paulkilroy/EllaFi/kicad/EllaFi-PCB.kicad_pcb

## KiCad design kicad/EllaFi-PCB.kicad_pcb (2026-08-12)

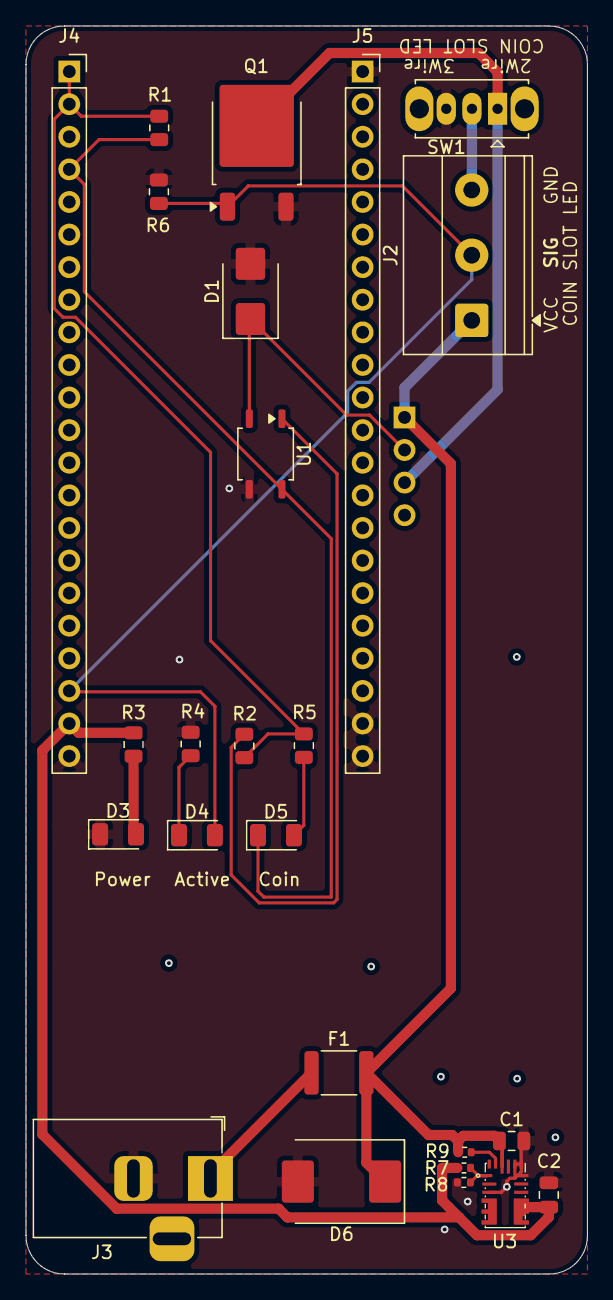
[picture p2: board EllaFi-PCB.kicad_pcb from above]

Board: 2 copper layers, 43.8 x 97.2 mm, 26 parts (1 on the bottom side), 16 nets.

Parts:
C1: 10 µF; C_0805_2012Metric
C2: 22 µF; C_0805_2012Metric
D1: P6SMB6.8A; D_SMB
D3: LED-RED; LED_1206_3216Metric
D4: LED-YELLOW; LED_1206_3216Metric
D5: LED-GREEN; LED_1206_3216Metric
D6: 1.5SMC18A; D_SMC
F1: MINISMDC150F/16-2; Fuse_1812_4532Metric
J1: Conn_01x04_Socket; PinSocket_1x04_P2.54mm_Vertical
J2: Conn_01x03; TerminalBlock_Phoenix_MKDS-1,5-3-5.08_1x03_P5.08mm_Horizont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
J3: PJ-002AH; BarrelJack_Horizontal
J4, J5: Conn_01x22_Socket; PinSocket_1x22_P2.54mm_Vertical
Q1: AOD4184A; TO-252-2
R1: 2.2k; R_0805_2012Metric
R2, R4: 220; R_0805_2012Metric
R3: 330; R_0805_2012Metric
R5: 1k; R_0805_2012Metric
R6: 10k; R_0805_2012Metric
R7, R9: 100 kΩ; R_0402_1005Metric
R8: 19.1 kΩ; R_0402_1005Metric
SW1: OS102011MS2QN1; SW_Slide_SPDT_Straight_CK_OS102011MS2Q
U1: FOD817S; SOP-4_3.8x4.1mm_P2.54mm
U3: MPM3620AGQV-Z; QFN-20_L5.0-W3.0-TL-MPM3630GQV-Z

Connections:
+12V: F1.1, J3.1
/3V3: J4.1, J4.2, R1.2, R2.1, R5.1
/5V: C2.1, J4.21, R3.1, R7.1, U3.9 (OUT)
/GPIO4: D5.1 (K), J4.4, R1.1, U1.4
/GPIO14: D4.2 (A), J2.2, J4.20, Q1.1 (G), R6.2
GND: C1.2, C2.2, D1.2 (A2), D3.1 (K), D6.2 (A2), J3.2, J4.22, J5.1, J5.21, J5.22, Q1.3 (S), R4.2, R6.1, R8.2, SW1.3 (C), U1.3, U3.3 (AGND), U3.12 (PGND), U3.13 (PGND), U3.14 (PGND)
unnamed: D1.1 (A1), J1.2, U1.2
unnamed: D3.2 (A), R3.2
unnamed: D4.1 (K), R4.1
unnamed: D5.2 (A), R5.2
unnamed: C1.1, D6.1 (A1), F1.2, J1.1, J2.1, R9.1, U3.16 (IN)
unnamed: J1.3, Q1.2 (D), SW1.1 (A)
unnamed: J2.3, SW1.2 (B)
unnamed: R2.2, U1.1
unnamed: R9.2, U3.17 (EN)
unnamed: R7.2, R8.1, U3.1 (FB)
