paulkilroy/EllaFi/src/web.cpp

#include "web.h"
#include "network.h"
#include "log_buffer.h"
#include "money_store.h"

#include <LittleFS.h>
#include <ESPmDNS.h>
#include <ArduinoJson.h>
#include <map>
#include <set>
#include <vector>
#include <Update.h>
#include <Preferences.h>
#include <HTTPClient.h>
#include <WiFiClientSecure.h>
#include "lwip/sockets.h"   // setsockopt + SO_KEEPALIVE / TCP_KEEPIDLE for per-socket TCP keepalive
#include <esp_ota_ops.h>
#include <esp_partition.h>
#include <PsychicUploadHandler.h>
#include <mbedtls/base64.h>
#include <mbedtls/md.h>
#include <esp_random.h>
#include <esp_log.h>
#include "logger.h"

static const char* TAG = "EllaFi";

// ── Admin auth: challenge-response login + IP-bound session token ──────────────
// HTTP Basic mailed the Omada password (base64) on every request. Instead, the browser sends
// sha256(nonce:password) — the password never crosses the wire — and on success the cookie is a
// token DERIVED from the password (sha256 of a salt + password), not a random session: no server
// state, so it survives the daily reboot and brownouts, and every admin device shares it. Changing
// the password is the revocation. The server is single-threaded (one httpd task), so these tables
// need no lock.

static const uint32_t ADMIN_NONCE_TTL_MS     = 60000UL;        // 1 min to finish a login
static const int      ADMIN_MAX_FAILS        = 5;              // failed logins per IP before cooldown
static const uint32_t ADMIN_FAIL_COOLDOWN_MS = 60000UL;        // lockout window once tripped

struct AdminNonce   { String nonce; uint32_t expiresMs; };
struct AdminFails   { uint32_t ip; int count; uint32_t untilMs; };

static AdminNonce   ADMIN_NONCES[8];
static AdminFails   ADMIN_FAILS[8];

static bool ttlLive(uint32_t expiresMs, uint32_t now) { return (int32_t)(expiresMs - now) > 0; }

static uint32_t reqIpU32(PsychicRequest* request) {
  IPAddress ip = request->client()->remoteIP();
  return ((uint32_t)ip[0] << 24) | ((uint32_t)ip[1] << 16) | ((uint32_t)ip[2] << 8) | (uint32_t)ip[3];
}

static String randomHex(int nbytes) {
  String s; s.reserve(nbytes * 2);
  for (int i = 0; i < nbytes; i++) { char b[3]; snprintf(b, sizeof(b), "%02x", (unsigned)(esp_random() & 0xff)); s += b; }
  return s;
}

static String sha256Hex(const String& in) {
  uint8_t out[32];
  mbedtls_md(mbedtls_md_info_from_type(MBEDTLS_MD_SHA256), (const uint8_t*)in.c_str(), in.length(), out);
  String hex; hex.reserve(64);
  for (int i = 0; i < 32; i++) { char b[3]; snprintf(b, sizeof(b), "%02x", out[i]); hex += b; }
  return hex;
}

// Constant-time compare of two equal-length strings.
static bool ctEqual(const String& a, const String& b) {
  if (a.length() != b.length()) return false;
  uint8_t diff = 0;
  for (size_t i = 0; i < a.length(); i++) diff |= (uint8_t)(a[i] ^ b[i]);
  return diff == 0;
}

static String cookieValue(PsychicRequest* request, const char* name) {
  size_t len = httpd_req_get_hdr_value_len(request->request(), "Cookie");
  if (len == 0 || len >= 512) return "";
  char buf[512] = {};
  httpd_req_get_hdr_value_str(request->request(), "Cookie", buf, sizeof(buf));
  String cookies(buf);
  String key = String(name) + "=";
  int p = cookies.indexOf(key);
  if (p < 0) return "";
  p += key.length();
  int e = cookies.indexOf(';', p);
  String v = (e < 0) ? cookies.substring(p) : cookies.substring(p, e);
  v.trim();
  return v;
}

// The persistent admin cookie value: derived from the password, computed once. Not IP-bound (phones
// hop DHCP leases) and never expires — accepted tradeoff on this LAN; rotate the password to revoke.
static String persistentToken() {
  static String token;
  if (token.isEmpty()) token = sha256Hex("ellafi-cookie-v1:" + ADMIN_PASSWORD);
  return token;
}

static bool isAuthorized(PsychicRequest* request) {
  return ctEqual(cookieValue(request, "ellafi_admin"), persistentToken());
}

// Admin gate as a pipeline middleware — attach with ->addMiddleware(adminAuth) on protected routes.
// Runs before the handler; 401s unauthenticated requests so the policy lives in the route table (not
// scattered through handler bodies).
static PsychicMiddlewareCallback adminAuth =
  [](PsychicRequest* request, PsychicResponse* response, PsychicMiddlewareNext next) -> esp_err_t {
    if (!isAuthorized(request))
      return response->send(401, "application/json", "{\"error\":\"auth required\"}");  // client renders its own login
    return next();
  };

static esp_err_t handleAdminChallenge(PsychicRequest* request, PsychicResponse* response) {
  uint32_t now = millis();
  String nonce = randomHex(16);
  int slot = 0; uint32_t oldest = 0xffffffffUL;
  for (int i = 0; i < 8; i++) {
    if (!ttlLive(ADMIN_NONCES[i].expiresMs, now)) { slot = i; break; }   // free/expired
    if (ADMIN_NONCES[i].expiresMs < oldest) { oldest = ADMIN_NONCES[i].expiresMs; slot = i; }
  }
  ADMIN_NONCES[slot] = { nonce, now + ADMIN_NONCE_TTL_MS };
  response->addHeader("Cache-Control", "no-store");
  return response->send(200, "application/json", (String("{\"nonce\":\"") + nonce + "\"}").c_str());
}

static void recordFail(uint32_t ip, uint32_t now) {
  for (auto& f : ADMIN_FAILS) if (f.ip == ip) {
    if (!ttlLive(f.untilMs, now)) f.count = 0;   // window elapsed → start over
    f.count++; f.untilMs = now + ADMIN_FAIL_COOLDOWN_MS; return;
  }
  for (auto& f : ADMIN_FAILS) if (f.ip == 0 || !ttlLive(f.untilMs, now)) {
    f = { ip, 1, now + ADMIN_FAIL_COOLDOWN_MS }; return;
  }
}
static void clearFails(uint32_t ip) { for (auto& f : ADMIN_FAILS) if (f.ip == ip) f = {}; }
static bool throttled(uint32_t ip, uint32_t now) {
  for (auto& f : ADMIN_FAILS) if (f.ip == ip && f.count >= ADMIN_MAX_FAILS && ttlLive(f.untilMs, now)) return true;
  return false;
}

static esp_err_t handleAdminLogin(PsychicRequest* request, PsychicResponse* response) {
  uint32_t now = millis(), ip = reqIpU32(request);
  if (throttled(ip, now)) return response->send(429, "application/json", "{\"error\":\"too many attempts — wait a minute\"}");

  JsonDocument doc;
  if (deserializeJson(doc, request->body())) return response->send(400, "application/json", "{\"error\":\"bad request\"}");
  String nonce  = doc["nonce"].as<String>();
  String digest = doc["digest"].as<String>();

  bool nonceOk = false;
  for (auto& n : ADMIN_NONCES) if (!n.nonce.isEmpty() && n.nonce == nonce && ttlLive(n.expiresMs, now)) {
    n = {};            // burn — use once
    nonceOk = true; break;
  }

  bool ok = nonceOk && digest.length() == 64 && ctEqual(digest, sha256Hex(nonce + ":" + ADMIN_PASSWORD));
  if (!ok) {
    recordFail(ip, now);
    return response->send(401, "application/json", "{\"error\":\"invalid password\"}");
  }
  clearFails(ip);

  // Persistent cookie (10 years) — survives the daily reboot and brownouts; no re-login.
  String cookie = "ellafi_admin=" + persistentToken() + "; Path=/; Max-Age=315360000; HttpOnly; SameSite=Strict";
  response->addHeader("Set-Cookie", cookie.c_str());
  return response->send(200, "application/json", "{\"ok\":true}");
}

static esp_err_t handleAdminLogout(PsychicRequest* request, PsychicResponse* response) {
  response->addHeader("Set-Cookie", "ellafi_admin=; Path=/; Max-Age=0; HttpOnly; SameSite=Strict");
  return response->send(200, "application/json", "{\"ok\":true}");
}

static esp_err_t handleSha256Js(PsychicRequest* request, PsychicResponse* response) {
  response->addHeader("Cache-Control", "max-age=86400");
  return response->send(200, "application/javascript",
    (const uint8_t*)web_sha256_min_js_start,
    web_sha256_min_js_end - web_sha256_min_js_start);
}

esp_err_t handleAdminPage(PsychicRequest* request, PsychicResponse* response) {
  // Unauthenticated on purpose: the page renders its own login overlay, then the gated
  // data endpoints (/admin/nodes, etc.) enforce auth.
  response->addHeader("Cache-Control", "no-store");
  return response->send(200, "text/html",
    (const uint8_t*)web_admin_html_start,
    web_admin_html_end - web_admin_html_start);
}

// ── HTTP / WS handlers ────────────────────────────────────────────────────────

// Seed the session cache from Omada's redirect params (clientMac required, rest best-effort) and
// restore any paused time from disk. Shared by handleRoot (ESP-served portal: params on GET /) and
// handleGetStatus (controller-hosted portal: params on GET /status — the page loads from the OC220,
// so this is the only request that can carry them).
static SessionParams& seedPortalSession(PsychicRequest* request, const String& clientIp, const String& clientMac) {
  SessionParams& session = HOTSPOT_SESSION_CACHE.upsert(clientIp, clientMac);
  if (request->hasParam("apMac"))    session.apMac    = request->getParam("apMac")->value();
  if (request->hasParam("ssidName")) session.ssidName = request->getParam("ssidName")->value();
  if (request->hasParam("radioId"))  session.radioId  = request->getParam("radioId")->value();

  // Load paused session from disk if needed (outside session mutex — only LittleFS I/O)
  if (hasPausedSessionFile(clientMac) && session.pausedRemainingMillis == 0)
    session.pausedRemainingMillis = loadPausedSessionFile(clientMac);
  return session;
}

// Serve captive portal page. Omada redirects here with query params:
// ?clientMac=...&apMac=...&ssidName=...&radioId=...&site=...&redirectUrl=...
esp_err_t handleRoot(PsychicRequest* request, PsychicResponse* response) {
#ifdef TEST_MODE
  String clientIp = request->hasParam("clientIp") ? request->getParam("clientIp")->value() : request->client()->remoteIP().toString();
#else
  String clientIp = request->client()->remoteIP().toString();
#endif
  String clientMac  = request->hasParam("clientMac")  ? request->getParam("clientMac")->value()  : "";
  String apMac      = request->hasParam("apMac")      ? request->getParam("apMac")->value()      : "";
  String ssidName   = request->hasParam("ssidName")   ? request->getParam("ssidName")->value()   : "";
  String radioId    = request->hasParam("radioId")    ? request->getParam("radioId")->value()     : "";

  SessionParams* existing = HOTSPOT_SESSION_CACHE.findByIp(clientIp);
  bool isNew = (existing == nullptr || existing->clientMac.isEmpty());

  ESP_LOGD(TAG, "handleRoot [%s] ip=%s mac=%s apMac=%s ssid=%s radioId=%s paused=%lums openConn=%d",
    isNew ? "NEW" : "RETURNING",
    clientIp.c_str(), clientMac.c_str(), apMac.c_str(),
    ssidName.c_str(), radioId.c_str(),
    existing ? existing->pausedRemainingMillis : 0UL,
    (int)HTTP_SERVER.getClientList().size());

  // Guard: if clientMac is missing, look up by IP — do NOT upsert yet (would create a phantom entry)
  if (clientMac.isEmpty()) {
    if (!existing || existing->clientMac.isEmpty()) {
      ESP_LOGI(TAG, "No MAC for IP %s — rejecting portal request", clientIp.c_str());
      return response->send(200, "text/html",
        (const uint8_t*)web_unidentified_html_start,
        web_unidentified_html_end - web_unidentified_html_start);
    }
    clientMac = existing->clientMac;
    ESP_LOGI(TAG, "Restored MAC %s from cache for IP %s", clientMac.c_str(), clientIp.c_str());
  }

  seedPortalSession(request, clientIp, clientMac);

  response->addHeader("Connection", "close");
  response->addHeader("Cache-Control", "no-store");
  return response->send(200, "text/html",
    (const uint8_t*)web_index_html_start,
    web_index_html_end - web_index_html_start);
}

esp_err_t handleGetStatus(PsychicRequest* request, PsychicResponse* response) {
#ifdef TEST_MODE
  String clientIp = request->hasParam("clientIp") ? request->getParam("clientIp")->value() : request->client()->remoteIP().toString();
#else
  String clientIp = request->client()->remoteIP().toString();
#endif
  // Controller-hosted portal: the page can't seed the session via GET / (it loads from the OC220),
  // so it passes Omada's redirect params here instead — same fields, same trust as handleRoot.
  SessionParams* session = request->hasParam("clientMac")
    ? &seedPortalSession(request, clientIp, request->getParam("clientMac")->value())
    : HOTSPOT_SESSION_CACHE.findByIp(clientIp);
  // AP status is global, not per-session — include it even when this client has no session, or the
  // coverage-map dots stay grey for anyone who hasn't paid yet (i.e. most captive-page viewers).
  String json = session ? buildStatusJson(*session)
    : "{\"type\":\"status\",\"sessionEndMillis\":0,\"pausedRemainingMillis\":0,\"coinInsertTimeLeft\":0,\"devices\":"
      + deviceStatusJson() + "}";
  response->addHeader("Cache-Control", "no-store");
  response->addHeader("Access-Control-Allow-Origin", "*");   // readable from the controller-hosted page
  return response->send(200, "application/json", json.c_str());
}

esp_err_t handleNotFound(PsychicRequest* request, PsychicResponse* response) {
  String host = request->host();
  String url  = request->url();  // full path + query string
  if (host != "ellafi.local" && host != WiFi.localIP().toString())
    ESP_LOGI(TAG, "404 unexpected host: %s %s", host.c_str(), url.c_str());  // captive-portal probes — expected, not an error
  else
    ESP_LOGI(TAG, "404: %s", url.c_str());
  return response->send(404, "text/plain", "Not found");
}

esp_err_t handleProgram(PsychicRequest* request, PsychicResponse* response) {
  COINSLOT_PROGRAM_MODE = true;
  digitalWrite(COINSLOT_POWER_PIN, HIGH);
  ESP_LOGI(TAG, "Coin slot program mode enabled — relay held HIGH until restart");
  return response->send(200, "text/plain", "Coin slot program mode ON — power held until restart.\nRestart ESP32 to exit.");
}

static String formatTimestamp(long ts) {
  char buf[20];
  time_t t = (time_t)ts;
  struct tm* tm = gmtime(&t);
  strftime(buf, sizeof(buf), "%Y-%m-%d %H:%M:%S", tm);
  return String(buf);
}

esp_err_t handleRefunds(PsychicRequest* request, PsychicResponse* response) {
  if (!fsExists("/refunds.log")) return response->send(200, "text/plain", "No refunds logged.");
  File f = LittleFS.open("/refunds.log", FILE_READ);
  if (!f) return response->send(500, "text/plain", "Could not open refunds.log");
  String out = "REFUNDS\n=======\n";
  while (f.available()) {
    String line = f.readStringUntil('\n');
    line.trim();
    if (line.isEmpty()) continue;
    JsonDocument doc;
    if (deserializeJson(doc, line) != DeserializationError::Ok) continue;
    out += formatTimestamp(doc["ts"] | 0L);
    out += "  " + String(doc["mac"] | "?");
    out += "  " + String(doc["coins"] | 0) + " coin(s)";
    out += " / " + String(doc["minutes"] | 0) + " min";
    out += "  Code: " + String(doc["code"] | "?");
    out += "\n";
  }
  f.close();
  return response->send(200, "text/plain", out.c_str());
}

esp_err_t handleErrors(PsychicRequest* request, PsychicResponse* response) {
  if (!fsExists("/errors.log")) return response->send(200, "text/plain", "No errors logged.");

  // Render only the most recent entries. The file can hold hundreds; assembling them all into one
  // String overruns the heap (yields an empty/failed response). Two passes: count, then skip all
  // but the last MAX_SHOW so `out` stays small regardless of file size.
  const int MAX_SHOW = 200;
  int total = 0;
  {
    File f = LittleFS.open("/errors.log", FILE_READ);
    if (!f) return response->send(500, "text/plain", "Could not open errors.log");
    while (f.available()) { String l = f.readStringUntil('\n'); l.trim(); if (!l.isEmpty()) total++; }
    f.close();
  }
  int skip = total > MAX_SHOW ? total - MAX_SHOW : 0;

  File f = LittleFS.open("/errors.log", FILE_READ);
  if (!f) return response->send(500, "text/plain", "Could not open errors.log");
  String out = "ERRORS\n======\n";
  if (skip) out += "(showing last " + String(MAX_SHOW) + " of " + String(total) + ")\n";
  int idx = 0;
  while (f.available()) {
    String line = f.readStringUntil('\n');
    line.trim();
    if (line.isEmpty()) continue;
    if (idx++ < skip) continue;
    JsonDocument doc;
    if (deserializeJson(doc, line) != DeserializationError::Ok) continue;
    long ts = doc["ts"] | 0L;
    if (ts < NTP_EPOCH_MIN)   // logged before clock sync (power-cut boot) — only boot-relative time exists
      out += "(boot +" + String((doc["ms"] | 0UL) / 1000) + "s)      ";
    else
      out += formatTimestamp(ts);
    out += "  [" + String(doc["tag"] | "?") + "]";
    out += "  " + String(doc["msg"] | "?");
    out += "\n";
  }
  f.close();
  return response->send(200, "text/plain", out.c_str());
}

void handleWsOpen(PsychicWebSocketClient* client) {
  int socketFd = client->socket();
  String clientIp = client->remoteIP().toString();
  ESP_LOGI(TAG, "WS client connected: socket #%d from %s", socketFd, clientIp.c_str());

  SessionParams* session = HOTSPOT_SESSION_CACHE.findByIp(clientIp);
  if (session) {
    session->socketFd = socketFd;
    ESP_LOGI(TAG, "WS client has session: socket #%d -> MAC %s", socketFd, session->clientMac.c_str());
  } else {
    ESP_LOGI(TAG, "WS socket #%d from %s: no cached session for this IP", socketFd, clientIp.c_str());
  }

  if (coinSessionUpdateSocket(clientIp, socketFd))
    ESP_LOGI(TAG, "Updated coin-session socket to %d (client reconnected)", socketFd);
}

// Reply with a terminal error, then aggressively close the socket. These are dead-end replies —
// the client can't act further on this connection — and a backgrounded/stale client may never close
// on its own, pinning a slot in PsychicHttp's small socket pool. close() just triggers an async
// close (httpd_sess_trigger_close), so it's safe from inside the frame handler.
static esp_err_t wsError(PsychicWebSocketRequest* request, const char* json) {
  request->reply(json);
  request->client()->close();
  return ESP_OK;
}

esp_err_t handleWsRequest(PsychicWebSocketRequest* request, httpd_ws_frame* frame) {
  int socketFd = request->client()->socket();
  String clientIp = request->client()->remoteIP().toString();
  String payload((char*)frame->payload, frame->len);

  JsonDocument doc;
  DeserializationError error = deserializeJson(doc, payload);
  if (error) {
    ESP_LOGE(TAG, "WS JSON parse error (%s): %.200s", error.c_str(), payload.c_str());
    return wsError(request, "{\"type\":\"error\",\"message\":\"Invalid WS JSON Request\"}");
  }

#ifdef TEST_MODE
  String payloadIp = doc["clientIp"] | "";
  if (!payloadIp.isEmpty()) clientIp = payloadIp;
#endif

  ESP_LOGD(TAG, "WS frame from socket #%d: clientIp=%s action=%s", socketFd, clientIp.c_str(), (doc["action"] | ""));

  SessionParams* session = HOTSPOT_SESSION_CACHE.findByIp(clientIp);
  if (session) {
    session->socketFd = socketFd;
    session->clientIp = clientIp;
  }

  if (!session) {
    return wsError(request, "{\"type\":\"error\",\"subtype\":\"no_session\",\"message\":\"No portal session found for this device\"}");
  }

  String action = doc["action"] | "";

  if (action == "getStatus") {
    if (coinSessionUpdateSocket(clientIp, socketFd))
      ESP_LOGI(TAG, "Updated coin-session socket to %d (client reconnected)", socketFd);
    request->client()->sendMessage(buildStatusJson(*session).c_str());

  } else if (action == "startCoinInsert") {
    if (!isServiceReady()) {
      return wsError(request, "{\"type\":\"error\",\"message\":\"Temporarily out of service — please try again shortly\"}");
    } else if (coinSessionTryClaim(socketFd, clientIp)) {
      ESP_LOGI(TAG, "Coin insertion started for MAC: %s via WS", session->clientMac.c_str());
      request->client()->sendMessage(buildStatusJson(*session).c_str());
    } else {
      return wsError(request, "{\"type\":\"error\",\"message\":\"Another user already inserting coins\"}");
    }

  } else if (action == "pause") {
    WsJob job(JOB_PAUSE, session->clientMac);
    xQueueSend(WEBSOCKET_JOB_QUEUE, &job, 0);

  } else if (action == "resume") {
    WsJob job(JOB_RESUME, session->clientMac);
    xQueueSend(WEBSOCKET_JOB_QUEUE, &job, 0);

#ifdef TEST_MODE
  } else if (action == "testInsertCoin") {
    // Simulate a coin pulse (assumes startCoinInsert was called first)
    coinButtonPulse();
    ESP_LOGI(TAG, "Test coin inserted for MAC: %s (count: %d)", session->clientMac.c_str(), COIN_COUNT.load());
#endif
  } else {
    return wsError(request, "{\"type\":\"error\",\"message\":\"Unknown action\"}");
  }

  return ESP_OK;
}

void handleWsClose(PsychicWebSocketClient* client) {
  ESP_LOGI(TAG, "WS client disconnected: socket #%d", client->socket());
}

String buildStatusJson(const SessionParams& session, const char* type) {
  CoinSessionStatus cs = coinSessionSnapshot();
  bool myCoinInsertActive = cs.accepting && coinIpToU32(session.clientIp) == cs.clientIpV4;
  int coinInsertTimeLeft = 0;
  if (myCoinInsertActive) {
    unsigned long now = millis();
    if (cs.deadlineMs > now) coinInsertTimeLeft = (cs.deadlineMs - now) / 1000;
  }

  String json = "{";
  json += "\"type\":\"" + String(type) + "\",";
  json += "\"coinCount\":" + String(myCoinInsertActive ? cs.count : 0) + ",";
  json += "\"coinInsertTimeLeft\":" + String(coinInsertTimeLeft) + ",";
  json += "\"sessionStartMillis\":" + String((unsigned long long)session.sessionStartMillis) + ",";
  json += "\"sessionEndMillis\":" + String((unsigned long long)session.sessionEndMillis) + ",";
  json += "\"pausedRemainingMillis\":" + String(session.pausedRemainingMillis) + ",";
  json += "\"clientMac\":\"" + session.clientMac + "\",";
  json += "\"clientIp\":\"" + session.clientIp + "\",";
  json += "\"minutesPerCoin\":" + String(MINUTES_PER_COIN);
  json += ",\"devices\":" + deviceStatusJson();   // AP coverage map: {mac:status} (2=online 1=issue 0=offline)
  json += "}";

  return json;
}

void pushCoinUpdateToClient() {
  CoinSessionStatus cs = coinSessionSnapshot();
  if (cs.socketFd < 0 || cs.clientIpV4 == 0) return;

  SessionParams* session = HOTSPOT_SESSION_CACHE.findByIp(coinU32ToIp(cs.clientIpV4));
  if (!session) return;

  PsychicWebSocketClient* ws = WEBSOCKET_HANDLER.getClient(cs.socketFd);
  if (ws != nullptr) ws->sendMessage(buildStatusJson(*session).c_str());
}

// ── OTA update ───────────────────────────────────────────────────────────────

void setupOtaRoute() {
  PsychicUploadHandler* otaHandler = new PsychicUploadHandler();

  otaHandler->onUpload([](PsychicRequest* request, const String& /*filename*/,
                          uint64_t index, uint8_t* data, size_t len, bool final) -> esp_err_t {
    if (index == 0) {
      if (!isAuthorized(request)) {
        ESP_LOGW(TAG, "OTA upload rejected: unauthorized");
        return ESP_FAIL;
      }
      size_t contentLen = request->contentLength();
      ESP_LOGI(TAG, "OTA fw upload start: %zu bytes", contentLen);
      if (!Update.begin(contentLen)) {
        ESP_LOGE(TAG, "OTA Update.begin failed: %s", Update.errorString());
        return ESP_FAIL;
      }
      ESP_LOGI("ota", "fw Update.begin OK");
    }

    if (Update.write(data, len) != len) {
      ESP_LOGE(TAG, "OTA write failed at offset %llu len %zu", index, len);
      return ESP_FAIL;
    }

    if (final) {
      ESP_LOGI("ota", "fw final chunk received: %llu bytes total — calling Update.end", index + len);
      if (!Update.end(true)) {
        ESP_LOGE(TAG, "OTA Update.end failed: %s", Update.errorString());
        return ESP_FAIL;
      }
      ESP_LOGI("ota", "fw Update.end OK — partition committed");
    }
    return ESP_OK;
  });

  otaHandler->onRequest([](PsychicRequest* /*request*/, PsychicResponse* response) -> esp_err_t {
    ESP_LOGI("ota", "fw onRequest fired — sending 200 OK, reboot in 500ms");
    response->send(200, "application/json", "{\"ok\":true}");
    // Reboot master — slaves detect version mismatch via heartbeat and self-update
    TimerHandle_t t = xTimerCreate("OtaReboot", pdMS_TO_TICKS(500), pdFALSE, NULL,
                                   [](TimerHandle_t) { esp_restart(); });
    if (t) xTimerStart(t, 0);
    else   esp_restart();
    return ESP_OK;
  });

  HTTP_SERVER.maxUploadSize = 16 * 1024 * 1024;
  HTTP_SERVER.on("/update", HTTP_POST, otaHandler);
}

// ── Firmware serve (for slave OTA) ───────────────────────────────────────────

esp_err_t handleFwBin(PsychicRequest* request, PsychicResponse* response) {
  uint32_t fw_size = RUNNING_IMAGE_SIZE;  // true running-image size — never a stale stored value

  if (fw_size == 0) {
    ESP_LOGW(TAG, "/fw.bin requested by %s but running image size is 0", request->client()->remoteIP().toString().c_str());
    return response->send(404, "text/plain", "Not found");
  }

  ESP_LOGI(TAG, "/fw.bin requested by %s — serving %u bytes from running partition",
           request->client()->remoteIP().toString().c_str(), (unsigned)fw_size);

  const esp_partition_t* partition = esp_ota_get_running_partition();
  response->addHeader("Content-Disposition", "attachment; filename=\"firmware.bin\"");

  // Stream directly from flash via mmap — no PSRAM copy needed.
  // response->send() with a raw pointer is synchronous, so munmap after is safe.
  const void* mapped = nullptr;
  spi_flash_mmap_handle_t mmap_handle;
  if (esp_partition_mmap(partition, 0, fw_size, SPI_FLASH_MMAP_DATA,
                         &mapped, &mmap_handle) == ESP_OK) {
    esp_err_t err = response->send(200, "application/octet-stream",
                                   (const uint8_t*)mapped, fw_size);
    spi_flash_munmap(mmap_handle);
    ESP_LOGI(TAG, "/fw.bin sent to %s (err=%d)", request->client()->remoteIP().toString().c_str(), err);
    return err;
  }

  // mmap failed — fall back to PSRAM copy
  ESP_LOGW(TAG, "/fw.bin: mmap failed, falling back to PSRAM copy");
  uint8_t* buf = (uint8_t*)heap_caps_malloc(fw_size, MALLOC_CAP_SPIRAM);
  if (!buf) {
    ESP_LOGE(TAG, "/fw.bin: PSRAM alloc failed for %u bytes", (unsigned)fw_size);
    return response->send(500, "text/plain", "Out of memory");
  }
  esp_partition_read(partition, 0, buf, fw_size);
  esp_err_t err = response->send(200, "application/octet-stream", buf, fw_size);
  heap_caps_free(buf);
  ESP_LOGI(TAG, "/fw.bin sent to %s (err=%d)", request->client()->remoteIP().toString().c_str(), err);
  return err;
}

// Serve the jsPDF library (embedded in firmware, so it ships with every flash — no separate
// FS step). Used by the admin page to generate voucher PDFs. Cached hard in the browser.
esp_err_t handleJsPdf(PsychicRequest* request, PsychicResponse* response) {
  response->addHeader("Cache-Control", "max-age=31536000, immutable");
  return response->send(200, "application/javascript",
    (const uint8_t*)web_jspdf_umd_min_js_start,
    web_jspdf_umd_min_js_end - web_jspdf_umd_min_js_start);
}


// ── Filesystem OTA ───────────────────────────────────────────────────────────

// PSRAM buffer for master's own FS self-flash, allocated during upload and freed after flashing.
static uint8_t* FS_PSRAM_BUFFER    = nullptr;
static size_t   FS_PSRAM_BUFFER_LEN = 0;
static size_t   FS_PSRAM_BUFFER_POS = 0;

void setupFsOtaRoute() {
  PsychicUploadHandler* fsHandler = new PsychicUploadHandler();

  fsHandler->onUpload([](PsychicRequest* request, const String& /*filename*/,
                         uint64_t index, uint8_t* data, size_t len, bool final) -> esp_err_t {
    if (index == 0) {
      if (!isAuthorized(request)) {
        ESP_LOGW(TAG, "FS OTA upload rejected: unauthorized");
        return ESP_FAIL;
      }
      size_t contentLen = request->contentLength();
      ESP_LOGI(TAG, "FS OTA upload start: %zu bytes", contentLen);
      if (FS_PSRAM_BUFFER) { heap_caps_free(FS_PSRAM_BUFFER); FS_PSRAM_BUFFER = nullptr; }
      FS_PSRAM_BUFFER    = (uint8_t*)heap_caps_malloc(contentLen, MALLOC_CAP_SPIRAM);
      FS_PSRAM_BUFFER_LEN = contentLen;
      FS_PSRAM_BUFFER_POS = 0;
      if (!FS_PSRAM_BUFFER) {
        ESP_LOGE("ota", "fs PSRAM alloc failed for %zu bytes", contentLen);
      } else {
        ESP_LOGI("ota", "fs PSRAM alloc OK: %zu bytes", contentLen);
      }
    }
    if (FS_PSRAM_BUFFER && FS_PSRAM_BUFFER_POS + len <= FS_PSRAM_BUFFER_LEN) {
      memcpy(FS_PSRAM_BUFFER + FS_PSRAM_BUFFER_POS, data, len);
      FS_PSRAM_BUFFER_POS += len;
    }
    if (final) {
      ESP_LOGI("ota", "fs upload final chunk done: %llu bytes total", index + len);
    }
    return ESP_OK;
  });

  fsHandler->onRequest([](PsychicRequest* /*request*/, PsychicResponse* response) -> esp_err_t {
    ESP_LOGI("ota", "fs onRequest fired — sending 200 OK");
    response->send(200, "application/json", "{\"ok\":true}");

    if (!FS_PSRAM_BUFFER || FS_PSRAM_BUFFER_LEN == 0) {
      ESP_LOGW("ota", "fs no PSRAM buf — skipping self-flash");
      return ESP_OK;
    }

    struct SavedFile { String path; uint8_t* buf; size_t len; };
    struct FsBuf {
      uint8_t* buf; size_t len;
      SavedFile preserved[4]; int nPreserved;
    };
    FsBuf* fb = new FsBuf{};
    fb->buf = FS_PSRAM_BUFFER;
    fb->len = FS_PSRAM_BUFFER_LEN;
    FS_PSRAM_BUFFER = nullptr;

    // Back up runtime data files before wiping the filesystem
    // config = device identity (loss = reprovision trip); vendo_history = the money journal;
    // refunds = outstanding customer codes; errors = reject/fraud trail; activity = client event log.
    // Everything else rebuilds.
    static const char* PRESERVE[] = {"/config.json", "/vendo_history.json", "/errors.log", "/refunds.log", "/activity.log"};
    fb->nPreserved = 0;
    for (auto path : PRESERVE) {
      if (!LittleFS.exists(path)) continue;
      File f = LittleFS.open(path, "r");
      if (!f) continue;
      size_t sz = f.size();
      uint8_t* b = (uint8_t*)heap_caps_malloc(sz, MALLOC_CAP_SPIRAM);
      if (b && f.read(b, sz) == sz) {
        fb->preserved[fb->nPreserved++] = {path, b, sz};
        ESP_LOGI(TAG, "FS OTA: preserved %s (%zu bytes)", path, sz);
      } else { heap_caps_free(b); }
      f.close();
    }

    TimerHandle_t t = xTimerCreate("FsFlash", pdMS_TO_TICKS(500), pdFALSE, fb,
      [](TimerHandle_t timer) {
        FsBuf* a = (FsBuf*)pvTimerGetTimerID(timer);
        ESP_LOGI("ota", "fs self-flash start: %zu bytes", a->len);
        LittleFS.end();
        bool beginOk = Update.begin(a->len, U_SPIFFS);
        if (!beginOk) {
          ESP_LOGE("ota", "fs Update.begin failed: %s", Update.errorString());
          for (int i = 0; i < a->nPreserved; i++) heap_caps_free(a->preserved[i].buf);
          heap_caps_free(a->buf); delete a; esp_restart(); return;
        }
        ESP_LOGI("ota", "fs Update.begin OK");
        size_t written = Update.write(a->buf, a->len);
        if (written != a->len) {
          ESP_LOGE("ota", "fs Update.write failed: wrote %zu of %zu", written, a->len);
          for (int i = 0; i < a->nPreserved; i++) heap_caps_free(a->preserved[i].buf);
          heap_caps_free(a->buf); delete a; esp_restart(); return;
        }
        ESP_LOGI("ota", "fs Update.write OK: %zu bytes", written);
        if (!Update.end(true)) {
          ESP_LOGE("ota", "fs Update.end failed: %s", Update.errorString());
          for (int i = 0; i < a->nPreserved; i++) heap_caps_free(a->preserved[i].buf);
          heap_caps_free(a->buf); delete a; esp_restart(); return;
        }
        ESP_LOGI("ota", "fs Update.end OK — partition committed");
        LittleFS.begin(false);
        heap_caps_free(a->buf);
        for (int i = 0; i < a->nPreserved; i++) {
          File rf = LittleFS.open(a->preserved[i].path, "w", true);
          if (rf) {
            rf.write(a->preserved[i].buf, a->preserved[i].len); rf.close();
            ESP_LOGI("ota", "fs restored %s", a->preserved[i].path.c_str());
          } else {
            ESP_LOGE("ota", "fs FAILED to restore %s", a->preserved[i].path.c_str());
          }
          heap_caps_free(a->preserved[i].buf);
        }
        delete a;
        ESP_LOGI("ota", "fs complete — rebooting");
        esp_restart();
      });
    if (t) xTimerStart(t, 0);
    else   esp_restart();
    return ESP_OK;
  });

  HTTP_SERVER.on("/update-fs", HTTP_POST, fsHandler);
}

// ── Admin nodes ───────────────────────────────────────────────────────────────

// Nodes: Omada is the source of truth. Each node's "nickname|commission" lives in its Omada client
// name; we cache it here (refreshed ≤1×/60s). No local fallback file — while the controller is
// unreachable AND the RAM cache is cold (fresh boot), nicknames simply display blank.
static std::map<String, String> NODE_ALIAS;       // mac (colon, upper) -> "nickname|commission"
static unsigned long NODE_ALIAS_SYNC_MS = 0;

static String macColonUpper(String m) { m.replace("-", ":"); m.toUpperCase(); return m; }

static void syncNodeAliases() {
  if (!IS_MASTER) return;
  if (NODE_ALIAS_SYNC_MS != 0 && millis() - NODE_ALIAS_SYNC_MS < 60000) return;  // throttle
  NODE_ALIAS_SYNC_MS = millis();
  JsonDocument all = getAllClientsJson();
  if (all.isNull()) return;                        // Omada down — keep what we have
  std::map<String, String> byMac;                  // colon-upper -> client name
  for (JsonObject c : all["result"]["data"].as<JsonArray>())
    byMac[macColonUpper(c["mac"].as<String>())] = c["name"].as<String>();
  std::vector<String> macs = { macColonUpper(WiFi.macAddress()) };   // master + known slaves
  for (const NodeInfo& ni : getKnownNodes()) macs.push_back(macColonUpper(ni.mac));
  for (const String& mac : macs) {
    auto it = byMac.find(mac);
    if (it != byMac.end() && it->second.indexOf('|') >= 0) NODE_ALIAS[mac] = it->second;
  }
}

esp_err_t handleAdminNodes(PsychicRequest* request, PsychicResponse* response) {
  JsonDocument doc;

  // Node nicknames and commissions come from the Omada client aliases (RAM cache, 60s sync).
  std::map<String, String> nicknames;
  std::map<String, int>    commissions;
  syncNodeAliases();
  for (auto& kv : NODE_ALIAS) {
    int bar = kv.second.indexOf('|');
    nicknames[kv.first]   = kv.second.substring(0, bar);
    commissions[kv.first] = kv.second.substring(bar + 1).toInt();
  }

  JsonArray nodes = doc["nodes"].to<JsonArray>();
  String ownMac = WiFi.macAddress();
  ownMac.toUpperCase();

  auto nickFor = [&](const String& mac) -> String {
    String upper = mac; upper.toUpperCase();
    auto it = nicknames.find(upper);
    return it != nicknames.end() ? it->second : "";
  };
  auto commFor = [&](const String& mac) -> int {
    String upper = mac; upper.toUpperCase();
    auto it = commissions.find(upper);
    return it != commissions.end() ? it->second : 0;
  };

  // Master node (self) — always online, info from own globals
  {
    JsonObject n = nodes.add<JsonObject>();
    n["mac"]        = WiFi.macAddress();
    n["ip"]         = WiFi.localIP().toString();
    n["role"]       = "master";
    n["nickname"]   = nickFor(ownMac);
    n["commission"] = commFor(ownMac);
    n["version"]    = FIRMWARE_VERSION;
    n["build"]      = (uint32_t)FIRMWARE_BUILD;
    n["uptimeSec"] = millis() / 1000UL;
    n["freeHeap"]  = ESP.getFreeHeap();
    n["rssi"]      = (int)WiFi.RSSI();
    n["tempC"]     = (int)temperatureRead();   // ESP32-S3 on-die temp (die, not ambient); master only for now
    n["rejW"]      = COIN_REJECT_WIDTH_COUNT.load();
    n["rejI"]      = COIN_REJECT_INTERVAL_COUNT.load();
    n["online"]    = true;
  }

  // Slave nodes seen via heartbeat
  unsigned long now = millis();
  for (const NodeInfo& ni : getKnownNodes()) {
    String mac = ni.mac;  mac.toUpperCase();
    if (mac == ownMac) continue;  // skip own heartbeat echo
    JsonObject n = nodes.add<JsonObject>();
    n["mac"]        = ni.mac;
    n["ip"]         = ni.ip;
    n["role"]       = "slave";
    n["nickname"]   = nickFor(ni.mac);
    n["commission"] = commFor(ni.mac);
    n["version"]    = ni.version;
    n["build"]      = ni.buildNumber;
    n["uptimeSec"] = ni.uptimeSec;
    n["freeHeap"]  = ni.freeHeap;
    n["rssi"]      = (int)ni.rssi;
    n["rejW"]      = ni.rejectWidth;
    n["rejI"]      = ni.rejectInterval;
    unsigned long downForMs = now - ni.lastSeenMs;
    n["online"]       = downForMs < NODE_OFFLINE_THRESHOLD_MILLIS;
    n["downForSec"]   = (uint32_t)(downForMs / 1000UL);   // seconds since last heartbeat — for the "down for" display
    n["otaSentCount"] = ni.otaSentCount;
    n["lastOtaSentMs"] = ni.lastOtaSentMs;
  }

  // Vendo active: sessions with sessionEndMillis > now
  int vendoActive = 0;
  {
    uint64_t nowMs = nowEpochMillis();
    HOTSPOT_SESSION_CACHE.lock();
    for (auto& kv : HOTSPOT_SESSION_CACHE) {
      if (kv.second.sessionEndMillis > nowMs) vendoActive++;
    }
    HOTSPOT_SESSION_CACHE.unlock();
  }
  doc["vendoActive"]   = vendoActive;
  doc["voucherActive"] = VOUCHER_ACTIVE_COUNT;
  doc["serviceReady"]  = isServiceReady();  // false → out of service: coins off, banner, red LED

  // Omada controller status (cached from GET settings/system/status)
  {
    JsonObject ctrl = doc["controller"].to<JsonObject>();
    ctrl["reachable"]    = CONTROLLER_STATUS.reachable;
    ctrl["model"]        = CONTROLLER_STATUS.model;
    ctrl["version"]      = CONTROLLER_STATUS.version;
    ctrl["timeZone"]     = CONTROLLER_STATUS.timeZone;
    ctrl["uptimeMs"]     = CONTROLLER_STATUS.uptimeMillis;
    ctrl["clockSkewSec"] = CONTROLLER_STATUS.clockSkewSec;
    ctrl["mgmtSsid"]       = MANAGEMENT_SSID;
    ctrl["mgmtSsidBreach"] = CONTROLLER_STATUS.mgmtSsidBreach;
    ctrl["siteLoaded"]     = !SITE_ID.isEmpty();  // for the out-of-service reason
  }

  // System health — master-only live metrics
  {
    JsonObject sys = doc["sys"].to<JsonObject>();
    sys["freeHeap"]           = ESP.getFreeHeap();
    sys["minFreeHeap"]        = ESP.getMinFreeHeap();
    sys["activeSockets"]      = (int)HTTP_SERVER.getClientList().size();
    sys["maxSockets"]         = HTTP_SERVER.config.max_open_sockets;
    sys["omadaSessionAgeMs"]  = getOmadaSessionAgeMs();
    sys["lastCacheRefreshMs"] = getLastCacheRefreshMs();
    sys["littleFsUsed"]       = LittleFS.usedBytes();
    sys["littleFsTotal"]      = LittleFS.totalBytes();
    sys["ntpSynced"]          = (time(NULL) > NTP_EPOCH_MIN);
    sys["fwSize"] = RUNNING_IMAGE_SIZE;
    sys["firmwareBuild"] = (uint32_t)FIRMWARE_BUILD;
  }

  String json;
  serializeJson(doc, json);
  response->addHeader("Cache-Control", "no-store");
  return response->send(200, "application/json", json.c_str());
}

// POST /admin/recheck — request a fresh controller refresh, on demand from the dashboard (on open and
// from the banner's "Re-check now" link). Status is otherwise only updated on coin/session events.
// Offload the refresh onto WebSocketTask (which already owns it) and return immediately; the client
// re-reads /admin/nodes a moment later. NOTE: this is good practice (no blocking TLS on the
// esp_http_server thread), but it was NOT what fixed the "xQueueGenericSend queue.c:832" corruption —
// that was setupOmada() re-creating CREDS_MUTEX on every controller-down retry (see omada.cpp). This
// offload only narrowed the race window; the real fix is the create-once guard there.
esp_err_t handleAdminRecheck(PsychicRequest* request, PsychicResponse* response) {
  WsJob j(JOB_REFRESH_CACHE, "");
  xQueueSend(WEBSOCKET_JOB_QUEUE, &j, 0);
  return response->send(200, "application/json", "{\"queued\":true}");
}

// ── Money record (NVS financial source-of-truth) ─────────────────────────────

// GET: the whole record (report source + off-device backup export).
esp_err_t handleAdminMoney(PsychicRequest* request, PsychicResponse* response) {
  response->addHeader("Cache-Control", "no-store");
  return response->send(200, "application/json", moneyRecordJson().c_str());
}

// POST: merge a Mac-side rollup (voucher_backup.py --rollup) into the record.
static long   localDayNum(time_t utc);        // defined with the report-bucket helpers below
static time_t localDayStartUtc(long dayNum);

esp_err_t handleAdminMoneyImport(PsychicRequest* request, PsychicResponse* response) {
  String err;
  int touched = moneyImport(request->body(), err);
  if (touched < 0) return response->send(400, "application/json", ("{\"error\":\"" + err + "\"}").c_str());

  // Optional seller-days backfill (scripts/backfill_seller_days.py): historic redeemed-as-sold
  // journal lines rebuilt from per-code startTime. Days already in the journal are skipped, so
  // re-imports are harmless and the nightly rollup's own lines always win.
  int daysAdded = 0;
  JsonDocument doc;
  if (deserializeJson(doc, request->body()) == DeserializationError::Ok && doc["sellerDays"].is<JsonArray>()) {
    std::set<long> have;
    if (fsExists("/seller_days.json")) {
      File f = LittleFS.open("/seller_days.json", FILE_READ);
      if (f) {
        while (f.available()) {
          String line = f.readStringUntil('\n'); line.trim();
          if (line.isEmpty()) continue;
          JsonDocument l;
          if (deserializeJson(l, line) == DeserializationError::Ok)
            have.insert(localDayNum((time_t)(l["ts"] | 0L)) - 1);
        }
        f.close();
      }
    }
    File f = LittleFS.open("/seller_days.json", FILE_APPEND);
    if (f) {
      for (JsonObject e : doc["sellerDays"].as<JsonArray>()) {
        long day = e["day"] | 0L;
        if (day <= 0 || have.count(day)) continue;
        JsonDocument line;
        line["ts"]      = (long)(localDayStartUtc(day + 1) + 9900);   // synth "2:45am after day ended" — the reader's day math inverts it
        line["sellers"] = e["sellers"];
        serializeJson(line, f);
        f.print('\n');
        daysAdded++;
      }
      f.close();
    }
  }
  return response->send(200, "application/json",
    ("{\"touched\":" + String(touched) + ",\"sellerDaysAdded\":" + String(daysAdded) + "}").c_str());
}

// One-time vendo-history migration. GET = dry run (per-month totals, no writes);
// POST = apply once (guarded; repeat POSTs get 409 — the nightly rollup keeps months fresh after).
esp_err_t handleAdminMoneyMigrate(PsychicRequest* request, PsychicResponse* response) {
  std::map<String, long> months;
  moneyVendoMonths(months);
  if (request->method() == HTTP_GET) {
    JsonDocument doc;
    doc["migrated"] = moneyVendoMigrated();
    doc["priceAssumption"] = PRICE_PER_COIN;
    JsonObject m = doc["months"].to<JsonObject>();
    for (auto& kv : months) m[kv.first] = kv.second;
    String json; serializeJson(doc, json);
    return response->send(200, "application/json", json.c_str());
  }
  if (moneyVendoMigrated())
    return response->send(409, "application/json", "{\"error\":\"already migrated\"}");
  for (auto& kv : months) {
    // voucher side untouched: import/rollup owns it (moneyImport semantics preserve the other side)
    String payload = "{\"income\":{\"" + kv.first + "\":{\"vendo\":" + String(kv.second) + "}}}";
    String err; moneyImport(payload, err);
  }
  moneyMarkVendoMigrated();
  moneyStoreSave();
  return response->send(200, "application/json", ("{\"applied\":" + String((int)months.size()) + "}").c_str());
}

#ifdef TEST_MODE
// Acceptor boot-glitch characterization: POST starts (cycles param, default 20), GET polls results.
// Bench-build only (like /diag/hammer) — used at board bring-up / new-acceptor commissioning to size
// COINSLOT_BOOT_SUPPRESS_MILLIS from measured data. Measured 2026-08-09: CH-926 power-on is clean.
esp_err_t handleCoinBootTest(PsychicRequest* request, PsychicResponse* response) {
  if (request->method() == HTTP_POST) {
    int cycles = request->hasParam("cycles") ? request->getParam("cycles")->value().toInt() : 20;
    if (!coinBootTestStart(cycles))
      return response->send(409, "application/json", "{\"error\":\"coin session active or test already running\"}");
    return response->send(200, "application/json", "{\"ok\":true}");
  }
  return response->send(200, "application/json", coinBootTestJson().c_str());
}
#endif

#ifdef TEST_MODE
// Stress endpoint: deliberately drives the controller refresh on THIS (httpd) thread AND enqueues a
// WS-task refresh, so multiple tasks hit getCredentials concurrently — reproduces the heap-clean
// "double owner" mutex corruption when the controller is down. Pair with test/crash_hammer.py.
esp_err_t handleDiagHammer(PsychicRequest* request, PsychicResponse* response) {
  { WsJob j(JOB_REFRESH_CACHE, ""); xQueueSend(WEBSOCKET_JOB_QUEUE, &j, 0); }
  refreshControllerStatus();
  return response->send(200, "application/json", "{\"ok\":true}");
}
#endif

// ── Socket-pool diagnostic ────────────────────────────────────────────────────
// Enumerate the web server's open sockets so we can see what's actually pinning the pool:
// how many are WebSockets vs plain HTTP, and which client IPs hold them (many distinct IPs =
// a portal storm; a few IPs each holding several = lingering keep-alive). The viewer's own
// request is one of the sockets listed.
esp_err_t handleAdminSockets(PsychicRequest* request, PsychicResponse* response) {
  JsonDocument doc;
  doc["max"] = HTTP_SERVER.config.max_open_sockets;
  int nWs = 0;
  JsonArray arr = doc["sockets"].to<JsonArray>();
  for (PsychicClient* c : HTTP_SERVER.getClientList()) {
    int fd  = c->socket();
    bool ws = WEBSOCKET_HANDLER.getClient(fd) != nullptr;
    if (ws) nWs++;
    JsonObject o = arr.add<JsonObject>();
    o["fd"] = fd;
    o["ip"] = c->remoteIP().toString();
    o["ws"] = ws;
  }
  doc["count"] = (int)arr.size();
  doc["ws"]    = nWs;
  doc["http"]  = (int)arr.size() - nWs;
  String out; serializeJson(doc, out);
  response->addHeader("Cache-Control", "no-store");
  return response->send(200, "application/json", out.c_str());
}

// ── Resource-utilization history (24 h) ───────────────────────────────────────
// The 30s sampler folds into a 10-min bucket holding that window's WORST moment (lowest free heap /
// PSRAM, highest socket count) so a brief portal storm still shows; buckets commit into a 144-slot
// ring = 24 h (~2.3 KB RAM). Feeds the admin's Resource Utilization graph. RAM-only, so the 3am reboot
// resets it — the durable crash/outage breadcrumbs are the WARN lines in errors.log, not this.
struct ResBucket { uint32_t t; uint32_t dram; uint32_t psram; uint16_t sock; };
static const int RES_N = 144;                        // 10-min buckets → last 24 h
static const uint32_t RES_BUCKET_MILLIS = 10UL * 60 * 1000;
static ResBucket RES_RING[RES_N];
static int RES_HEAD = 0, RES_COUNT = 0;
// in-progress bucket accumulator (worst-case since the last commit)
static uint32_t RES_ACC_DRAM = UINT32_MAX, RES_ACC_PSRAM = UINT32_MAX;
static uint16_t RES_ACC_SOCK = 0;
static bool     RES_ACC_DIRTY = false;
static unsigned long RES_BUCKET_START = 0;

void sampleResources() {
  uint32_t dram  = ESP.getFreeHeap();
  uint32_t psram = ESP.getFreePsram();
  uint16_t sock  = (uint16_t)HTTP_SERVER.getClientList().size();
  if (dram  < RES_ACC_DRAM)  RES_ACC_DRAM  = dram;   // min free = worst
  if (psram < RES_ACC_PSRAM) RES_ACC_PSRAM = psram;
  if (sock  > RES_ACC_SOCK)  RES_ACC_SOCK  = sock;   // max sockets = worst
  RES_ACC_DIRTY = true;

  if (RES_BUCKET_START == 0) RES_BUCKET_START = millis();
  if (millis() - RES_BUCKET_START >= RES_BUCKET_MILLIS) {
    ResBucket& b = RES_RING[RES_HEAD];
    b.t = (uint32_t)time(NULL); b.dram = RES_ACC_DRAM; b.psram = RES_ACC_PSRAM; b.sock = RES_ACC_SOCK;
    RES_HEAD = (RES_HEAD + 1) % RES_N;
    if (RES_COUNT < RES_N) RES_COUNT++;
    RES_ACC_DRAM = UINT32_MAX; RES_ACC_PSRAM = UINT32_MAX; RES_ACC_SOCK = 0;
    RES_ACC_DIRTY = false;
    RES_BUCKET_START = millis();
  }
}

esp_err_t handleResources(PsychicRequest* request, PsychicResponse* response) {
  JsonDocument doc;
  doc["maxSock"] = HTTP_SERVER.config.max_open_sockets;
  JsonArray arr = doc["samples"].to<JsonArray>();
  int start = (RES_HEAD - RES_COUNT + RES_N) % RES_N;
  for (int i = 0; i < RES_COUNT; i++) {              // oldest → newest, for left-to-right plotting
    ResBucket& b = RES_RING[(start + i) % RES_N];
    JsonObject o = arr.add<JsonObject>();
    o["t"] = (long)b.t; o["dram"] = b.dram; o["psram"] = b.psram; o["sock"] = b.sock;
  }
  if (RES_ACC_DIRTY) {                               // in-progress bucket → a live current bar (no 10-min wait)
    JsonObject o = arr.add<JsonObject>();
    o["t"] = (long)time(NULL); o["dram"] = RES_ACC_DRAM; o["psram"] = RES_ACC_PSRAM; o["sock"] = RES_ACC_SOCK;
  }
  String out; serializeJson(doc, out);
  response->addHeader("Cache-Control", "no-store");
  return response->send(200, "application/json", out.c_str());
}

// ── Admin log (ring buffer) ───────────────────────────────────────────────────

esp_err_t handleAdminLog(PsychicRequest* request, PsychicResponse* response) {
  uint32_t sinceSeq = request->hasParam("since")
    ? (uint32_t)atoi(request->getParam("since")->value().c_str()) : 0;

  static const int BATCH = 50;
  LogEntry* entries = (LogEntry*)malloc(BATCH * sizeof(LogEntry));
  if (!entries) return response->send(500, "text/plain", "oom");

  int count = logBufferSnapshot(entries, BATCH, sinceSeq);

  JsonDocument doc;
  doc["seq"] = logBufferLastSeq();
  JsonArray arr = doc["entries"].to<JsonArray>();
  for (int i = 0; i < count; i++) {
    JsonObject e = arr.add<JsonObject>();
    e["seq"]   = entries[i].seq;
    e["ms"]    = entries[i].uptimeMs;
    e["ts"]    = (long)entries[i].ts;
    e["level"] = String(entries[i].level);
    e["tag"]   = entries[i].tag;
    e["msg"]   = entries[i].msg;
  }
  free(entries);

  String json;
  serializeJson(doc, json);
  response->addHeader("Cache-Control", "no-store");
  return response->send(200, "application/json", json.c_str());
}

// ── Client activity log (coin auth/extend/refund/pause/resume) ────────────────
// Each line of /activity.log is already a JSON object; return the most recent MAX as a JSON array,
// newest first. Capped by COUNT (a busy day can grow the file past the boot purge) so the response
// never balloons into one huge String — see the no-whole-file-String rule.

esp_err_t handleActivity(PsychicRequest* request, PsychicResponse* response) {
  if (!fsExists("/activity.log")) return response->send(200, "application/json", "[]");
  File f = LittleFS.open("/activity.log", FILE_READ);
  if (!f) return response->send(500, "text/plain", "Could not open activity.log");

  static const int MAX = 200;
  std::vector<String> ring(MAX);  // heap-backed ring of the last MAX raw lines
  int n = 0, head = 0;
  while (f.available()) {
    String line = f.readStringUntil('\n');
    line.trim();
    if (line.isEmpty()) continue;
    ring[head] = line;
    head = (head + 1) % MAX;
    if (n < MAX) n++;
  }
  f.close();

  String out = "[";
  for (int i = 0; i < n; i++) {
    if (i) out += ',';
    out += ring[(head - 1 - i + 2 * MAX) % MAX];  // walk backwards = newest first
  }
  out += ']';
  response->addHeader("Cache-Control", "no-store");
  return response->send(200, "application/json", out.c_str());
}

// ── Admin sellers ─────────────────────────────────────────────────────────────

esp_err_t handleAdminSellers(PsychicRequest* request, PsychicResponse* response) {
  response->addHeader("Cache-Control", "no-store");
  if (request->method() == HTTP_GET) {
    // Sellers live in config.json (their only home since 2026-08-09); node aliases are RAM/controller.
    JsonDocument doc;
    {
      File f = LittleFS.open("/config.json", "r");
      if (f) {
        JsonDocument cfg;
        if (deserializeJson(cfg, f) == DeserializationError::Ok) doc["sellers"] = cfg["sellers"];
        f.close();
      }
    }
    if (!doc["sellers"].is<JsonArray>()) doc["sellers"].to<JsonArray>();
    doc["nodes"].to<JsonArray>();   // kept for UI shape; node data rides /admin/nodes
    String json; serializeJson(doc, json);
    return response->send(200, "application/json", json.c_str());
  }
  // POST — sellers array merges into config.json (same path the config editor uses)
  JsonDocument doc;
  if (deserializeJson(doc, request->body()) || !doc["sellers"].is<JsonArray>())
    return response->send(400, "text/plain", "Bad request");
  {
    JsonDocument merge;
    merge["sellers"] = doc["sellers"];
    String body; serializeJson(merge, body);
    String err;
    if (!mergeAndSaveConfig(body, err))
      return response->send(500, "text/plain", ("Failed to save config: " + err).c_str());
  }
  // Nodes: Omada is the source of truth — push each node's nickname|commission to its client alias.
  for (JsonObject n : doc["nodes"].as<JsonArray>()) {
    String mac = n["mac"].as<String>();
    if (mac.isEmpty()) continue;
    String alias = n["nickname"].as<String>() + "|" + String(n["commission"].as<int>());
    String err;
    if (!setClientName(mac, alias, err)) ESP_LOGW(TAG, "node alias PATCH %s failed: %s", mac.c_str(), err.c_str());
    NODE_ALIAS[macColonUpper(mac)] = alias;   // reflect immediately, before the next sync
  }
  return response->send(200, "application/json", "{\"ok\":true}");
}

// ── Admin vouchers ────────────────────────────────────────────────────────────

esp_err_t handleAdminVouchers(PsychicRequest* request, PsychicResponse* response) {
  response->addHeader("Cache-Control", "no-store");

  if (request->method() == HTTP_GET) {
    String groupId = request->hasParam("id") ? request->getParam("id")->value() : "";

    if (!groupId.isEmpty()) {
      // Return codes for a specific group page
      int page = request->hasParam("page") ? request->getParam("page")->value().toInt() : 1;
      JsonDocument raw = getVoucherCodesJson(groupId, page);
      if (raw.isNull()) return response->send(502, "text/plain", "Failed to fetch from controller");
      JsonDocument out;
      JsonArray codes = out["codes"].to<JsonArray>();
      for (JsonObject v : raw["result"]["data"].as<JsonArray>()) codes.add(v["code"].as<String>());
      int totalRows = raw["result"]["totalRows"].as<int>();
      out["totalPages"] = (totalRows + 129) / 130;
      String json; serializeJson(out, json);
      return response->send(200, "application/json", json.c_str());
    }

    // List all voucher groups filtered by AUTOGEN: prefix
    JsonDocument raw = getVoucherGroupsJson();
    if (raw.isNull()) return response->send(502, "text/plain", "Failed to fetch from controller");
    JsonDocument out;
    JsonArray arr = out.to<JsonArray>();
    for (JsonObject g : raw["result"]["data"].as<JsonArray>()) {
      String name = g["name"].as<String>();
      if (!name.startsWith("AUTOGEN: ")) continue;
      String rest   = name.substring(9);           // "5P2H KANO"
      int spaceIdx  = rest.indexOf(' ');
      String seller = spaceIdx >= 0 ? rest.substring(spaceIdx + 1) : "";
      int price = 0;
      {
        JsonDocument descDoc;
        if (deserializeJson(descDoc, g["description"].as<String>()) == DeserializationError::Ok)
          price = descDoc["price"].as<int>();
      }
      // totalCount: prefer top-level field, fall back to statisticsCount (structure varies between list and detail endpoints)
      int totalCount = g["totalCount"].as<int>();
      if (totalCount == 0) totalCount = g["statisticsCount"]["totalStatisticsCount"].as<int>();
      JsonObject entry = arr.add<JsonObject>();
      entry["id"]          = g["id"];
      entry["name"]        = name;
      entry["seller"]      = seller;
      entry["pages"]       = max(1, (totalCount + 129) / 130);
      entry["duration"]    = g["duration"].as<int>();
      entry["price"]       = price;
      entry["createdTime"] = g["createdTime"].as<uint64_t>();
      entry["unusedCount"] = g["unusedCount"].as<int>();
      entry["usedCount"]   = g["usedCount"].as<int>();
      entry["totalCount"]  = totalCount;
    }
    String json; serializeJson(out, json);
    return response->send(200, "application/json", json.c_str());
  }

  // DELETE — remove a voucher group
  if (request->method() == HTTP_DELETE) {
    String groupId = request->hasParam("id") ? request->getParam("id")->value() : "";
    if (groupId.isEmpty()) return response->send(400, "text/plain", "Missing id");
    String errorDetail;
    if (!deleteVoucherGroup(groupId, errorDetail))
      return response->send(502, "text/plain", ("Controller error: " + errorDetail).c_str());
    return response->send(200, "application/json", "{\"ok\":true}");
  }

  // POST — create new voucher group
  JsonDocument req;
  if (deserializeJson(req, request->body())) return response->send(400, "text/plain", "Bad JSON");
  int pages       = req["pages"].as<int>();
  int durationMin = req["duration_min"].as<int>();
  int price       = req["price"].as<int>();
  String seller   = req["seller"].as<String>();
  if (pages < 1 || durationMin < 1 || price < 1 || seller.isEmpty())
    return response->send(400, "text/plain", "Missing required fields");

  int qty          = pages * 130;
  int durationHrs  = durationMin / 60;
  // Short hex tag (low 24 bits of epoch, ≤6 chars) keeps each batch's name unique so the same
  // price/duration/seller can be re-stocked — the controller rejects duplicate group names (-42059).
  // Goes INSIDE the first space-free token; seller is still parsed as everything after the first space.
  String tag       = String((uint32_t)time(NULL) & 0xFFFFFFUL, HEX);
  String name      = "AUTOGEN: " + String(price) + "P" + String(durationHrs) + "H-" + tag + " " + seller;
  String desc      = "{\"price\":" + String(price) + "}";

  String groupId, errorDetail;
  if (!createVoucherGroup(name, durationMin, qty, desc, groupId, errorDetail))
    return response->send(502, "text/plain", ("Controller error: " + errorDetail).c_str());

  // Fetch first page of codes immediately so the browser can print without a second round-trip
  JsonDocument codesDoc = getVoucherCodesJson(groupId, 1);
  JsonDocument out;
  out["id"]    = groupId;
  out["pages"] = pages;
  JsonArray codes = out["codes"].to<JsonArray>();
  if (!codesDoc.isNull())
    for (JsonObject v : codesDoc["result"]["data"].as<JsonArray>()) codes.add(v["code"].as<String>());
  String json; serializeJson(out, json);
  return response->send(200, "application/json", json.c_str());
}

// ── Voucher cache helpers ─────────────────────────────────────────────────────

static JsonArray voucherBuckets(JsonDocument& doc) {
  JsonArray arr = doc["result"]["usage"].as<JsonArray>();
  if (arr.isNull()) arr = doc["result"]["data"].as<JsonArray>();
  return arr;
}

static int voucherBucketRevenue(JsonObject b, int fallbackPrice) {
  float amt = atof(b["amount"].as<const char*>() ?: "0");
  if (amt == 0) amt = b["count"].as<int>() * fallbackPrice;
  return (int)amt;
}

// ── Admin sales ───────────────────────────────────────────────────────────────

// Day bucketing in the controller's local time. TZ is set at startup from the
// controller's zone (applyControllerTimezone), so localtime()/mktime() apply the
// correct offset AND daylight-saving. localDayNum increments by 1 at each local
// midnight; localDayStartUtc is its inverse (UTC epoch of a local day's midnight),
// used for Omada range queries and as the voucher-cache key. DST-correct because
// the per-instant offset comes from localtime, not a fixed constant.

// Days since 1970-01-01 for a civil (proleptic Gregorian) date. Hinnant's algorithm.
static long daysFromCivil(int y, unsigned m, unsigned d) {
  y -= m <= 2;
  long era = (y >= 0 ? y : y - 399) / 400;
  unsigned yoe = (unsigned)(y - era * 400);
  unsigned doy = (153 * (m + (m > 2 ? -3 : 9)) + 2) / 5 + d - 1;
  unsigned doe = yoe * 365 + yoe / 4 - yoe / 100 + doy;
  return era * 146097 + (long)doe - 719468;
}
static long localDayNum(time_t utc) {
  struct tm lt;
  localtime_r(&utc, &lt);
  return daysFromCivil(lt.tm_year + 1900, lt.tm_mon + 1, lt.tm_mday);
}
static time_t localDayStartUtc(long dayNum) {
  time_t midnightAsUtc = (time_t)dayNum * 86400;
  struct tm lt;
  gmtime_r(&midnightAsUtc, &lt);   // recover Y/M/D 00:00:00 of that local day
  lt.tm_isdst = -1;
  return mktime(&lt);              // interpret as local → real UTC epoch (DST-aware)
}

// Voucher daily stats cache (day → {count, revenue}) — RAM only, repopulated lazily after each
// nightly reboot with ONE ranged controller fetch per dashboard window (was /voucher_history.json
// on LittleFS; moved to RAM 2026-08-09 — it is a pure cache, nothing to preserve).
static std::map<long, std::pair<int,int>> VCHR_DAY_CACHE;

// Ensure [winStart, winEnd) is populated. Days the API returns no bucket for cache as 0.
static void ensureVoucherDays(long winStart, long winEnd) {
  std::set<long> missing;
  for (long d = winStart; d < winEnd; d++) if (!VCHR_DAY_CACHE.count(d)) missing.insert(d);
  if (missing.empty()) return;
  // Omada end-stamps each daily bucket at the NEXT local midnight; widen the window a day so the
  // last missing day's bucket is comfortably inside it (extra buckets filtered below).
  JsonDocument hist = getVoucherHistoryJson(localDayStartUtc(*missing.begin()),
                                            localDayStartUtc(*missing.rbegin() + 2));
  if (hist.isNull()) return;                       // controller down — retry on the next load
  for (long d : missing) VCHR_DAY_CACHE[d];        // default-init {0,0}
  for (JsonObject b : voucherBuckets(hist)) {
    long day = localDayNum((time_t)(b["time"].as<long long>() / 1000) - 1);  // -1s: land in the day it represents
    if (!missing.count(day)) continue;
    auto& v = VCHR_DAY_CACHE[day];
    v.first  += b["count"].as<int>();
    v.second += voucherBucketRevenue(b, FALLBACK_PRICE_PER_VOUCHER);
  }
}

// Seller + price from an "AUTOGEN: <price-tag> <seller>" voucher group. Shared by the sales
// per-day leader and the leaderboard — the one attribution rule, written once.
static bool autogenSellerPrice(JsonObject g, String& seller, int& price) {
  String name = g["name"].as<String>();
  if (!name.startsWith("AUTOGEN: ")) return false;
  String rest = name.substring(9);
  int space   = rest.indexOf(' ');
  seller = space >= 0 ? rest.substring(space + 1) : rest;
  price  = PRICE_PER_COIN;
  JsonDocument descDoc;
  if (deserializeJson(descDoc, g["description"].as<String>()) == DeserializationError::Ok)
    price = descDoc["price"] | PRICE_PER_COIN;
  return true;
}

esp_err_t handleAdminSales(PsychicRequest* request, PsychicResponse* response) {
  response->addHeader("Cache-Control", "no-store");

  time_t now      = time(NULL);
  long   todayDay = localDayNum(now);
  static const int DAYS = 90;

  // Monthly rollup (last 12 months) — same logs, aggregated by calendar month for the month chart.
  static const int MONTHS = 12;
  int monthCoins[MONTHS] = {}, monthMin[MONTHS] = {}, monthVchr[MONTHS] = {}, monthVchrRev[MONTHS] = {};
  int mkNow; { time_t mid = (time_t)(todayDay * 86400 + 43200); struct tm* tm = gmtime(&mid);
               mkNow = (tm->tm_year + 1900) * 12 + tm->tm_mon; }
  auto monthSlot = [&](long dayNum) -> int {   // 0..MONTHS-1 (0=oldest, MONTHS-1=current); -1 if outside
    time_t mid = (time_t)(dayNum * 86400 + 43200); struct tm* tm = gmtime(&mid);
    int mi = mkNow - ((tm->tm_year + 1900) * 12 + tm->tm_mon);
    return (mi >= 0 && mi < MONTHS) ? (MONTHS - 1 - mi) : -1;
  };

  // ── Vendo history ──────────────────────────────────────────────────────────
  int dayCoinTotals[DAYS] = {};
  int dayMinTotals[DAYS]  = {};
  int daySessTotals[DAYS] = {};   // one appendSaleLog line ≈ one settled coin session ≈ one customer
  std::map<String, std::vector<int>> nodeCoins;
  std::map<String, std::vector<int>> nodeSess;   // per-node customer sessions, same day indexing

  if (fsExists("/vendo_history.json")) {
    File f = LittleFS.open("/vendo_history.json", FILE_READ);
    if (f) {
      while (f.available()) {
        String line = f.readStringUntil('\n'); line.trim();
        if (line.isEmpty()) continue;
        JsonDocument doc;
        if (deserializeJson(doc, line) != DeserializationError::Ok) continue;
        long day = localDayNum((time_t)(doc["ts"] | 0L));
        int  coins = doc["coins"] | 0;
        int  ms = monthSlot(day);                       // 12-month rollup (all history, not just DAYS)
        if (ms >= 0) { monthCoins[ms] += coins; monthMin[ms] += doc["min"] | 0; }
        int  idx = (int)(todayDay - day);
        if (idx < 0 || idx >= DAYS) continue;
        dayCoinTotals[DAYS - 1 - idx] += coins;
        dayMinTotals [DAYS - 1 - idx] += doc["min"] | 0;
        daySessTotals[DAYS - 1 - idx]++;
        String node = doc["node"] | "";
        if (!node.isEmpty()) {
          if (nodeCoins.find(node) == nodeCoins.end()) {
            nodeCoins[node].assign(DAYS, 0);
            nodeSess[node].assign(DAYS, 0);
          }
          nodeCoins[node][DAYS - 1 - idx] += coins;
          nodeSess[node][DAYS - 1 - idx]++;
        }
      }
      f.close();
    }
  }

  // ── Voucher history cache ──────────────────────────────────────────────────
  int dayVoucherTotals[DAYS] = {};
  int dayVchrRevTotals[DAYS] = {};

  // Past days from the RAM cache (one ranged fetch for whatever is missing)
  ensureVoucherDays(todayDay - (DAYS - 1), todayDay);
  auto& vchrCache = VCHR_DAY_CACHE;

  // Apply cached past days
  for (int i = 0; i < DAYS - 1; i++) {
    long day = todayDay - (DAYS - 1) + i;
    auto it = vchrCache.find(day);
    if (it != vchrCache.end()) {
      dayVoucherTotals[i] += it->second.first;
      dayVchrRevTotals[i] += it->second.second;
    }
  }

  // Always fetch today live — incomplete day, never cache
  {
    // Fetch the whole current local day; Omada returns the partial bucket end-stamped
    // at tomorrow's local midnight, which -1s attributes back to today.
    JsonDocument todayDoc = getVoucherHistoryJson(localDayStartUtc(todayDay), localDayStartUtc(todayDay + 1));
    if (!todayDoc.isNull()) {
      for (JsonObject b : voucherBuckets(todayDoc)) {
        long day = localDayNum((time_t)(b["time"].as<long long>() / 1000) - 1);
        if (day != todayDay) continue;
        dayVoucherTotals[DAYS - 1] += b["count"].as<int>();
        dayVchrRevTotals[DAYS - 1] += voucherBucketRevenue(b, FALLBACK_PRICE_PER_VOUCHER);
      }
    }
  }

  // Voucher monthly rollup: cached past days (365 kept) + today's live partial (not cached).
  for (auto& kv : vchrCache) {
    int ms = monthSlot(kv.first);
    if (ms >= 0) { monthVchr[ms] += kv.second.first; monthVchrRev[ms] += kv.second.second; }
  }
  { int ms = monthSlot(todayDay);
    if (ms >= 0) { monthVchr[ms] += dayVoucherTotals[DAYS - 1]; monthVchrRev[ms] += dayVchrRevTotals[DAYS - 1]; } }

  // ── Per-day top voucher seller (pesos) — redeemed = sold ───────────────────
  // Past days from the rollup journal: each 2:45am rollup logs every seller's usedCount delta
  // (what their customers redeemed the day that just ended). Today: live usedCount minus the
  // ledger's last-rollup count. Feeds the Leader column vs the day's best vendo node.
  std::map<long, std::map<String, int>> sellerDayRev;
  if (fsExists("/seller_days.json")) {
    File f = LittleFS.open("/seller_days.json", FILE_READ);
    if (f) {
      while (f.available()) {
        String line = f.readStringUntil('\n'); line.trim();
        if (line.isEmpty()) continue;
        JsonDocument doc;
        if (deserializeJson(doc, line) != DeserializationError::Ok) continue;
        long day = localDayNum((time_t)(doc["ts"] | 0L)) - 1;   // 2:45am rollup covers the day that ended
        if (day < todayDay - (DAYS - 1) || day > todayDay) continue;
        for (JsonPair kv : doc["sellers"].as<JsonObject>())
          sellerDayRev[day][String(kv.key().c_str())] += kv.value().as<int>();
      }
      f.close();
    }
  }
  {
    JsonDocument groupsDoc = getVoucherGroupsJson();
    if (!groupsDoc.isNull()) {
      for (JsonObject g : groupsDoc["result"]["data"].as<JsonArray>()) {
        String seller; int price;
        if (!autogenSellerPrice(g, seller, price)) continue;
        int  used = g["usedCount"] | 0;
        long prev = moneyGroupUsed(g["id"].as<String>());
        if (used > prev) sellerDayRev[todayDay][seller] += (int)((used - prev) * price);
      }
    }
  }

  // ── Build response ─────────────────────────────────────────────────────────
  static const char* MN[] = {"Jan","Feb","Mar","Apr","May","Jun","Jul","Aug","Sep","Oct","Nov","Dec"};
  JsonDocument out;
  out["pricePerCoin"]   = PRICE_PER_COIN;
  out["minutesPerCoin"] = MINUTES_PER_COIN;
  JsonArray months = out["months"].to<JsonArray>();
  for (int i = 0; i < MONTHS; i++) {
    int mkey = mkNow - (MONTHS - 1 - i);                 // i=0 oldest … MONTHS-1 current
    JsonObject m = months.add<JsonObject>();
    m["label"]      = String(MN[mkey % 12]) + " " + String(mkey / 12);
    m["coins"]      = monthCoins[i];
    m["minutes"]    = monthMin[i];
    m["vouchers"]   = monthVchr[i];
    m["voucherRev"] = monthVchrRev[i];
  }
  JsonArray days = out["days"].to<JsonArray>();
  for (int i = 0; i < DAYS; i++) {
    time_t   dayTs = (time_t)((todayDay - (DAYS - 1 - i)) * 86400 + 43200);
    struct tm* tm  = gmtime(&dayTs);
    char dateBuf[24];
    snprintf(dateBuf, sizeof(dateBuf), "%d/%d", tm->tm_mon + 1, tm->tm_mday);
    JsonObject d = days.add<JsonObject>();
    d["date"]       = dateBuf;
    d["coins"]      = dayCoinTotals[i];
    d["minutes"]    = dayMinTotals[i];
    d["vouchers"]   = dayVoucherTotals[i];
    d["voucherRev"] = dayVchrRevTotals[i];
    d["sessions"]   = daySessTotals[i];
    auto sd = sellerDayRev.find(todayDay - (DAYS - 1 - i));
    if (sd != sellerDayRev.end()) {
      const char* topName = nullptr; int topRev = 0;
      JsonObject sl = d["sellers"].to<JsonObject>();   // full per-seller pesos — feeds the trend chart
      for (auto& kv : sd->second) {
        sl[kv.first.c_str()] = kv.second;
        if (kv.second > topRev) { topName = kv.first.c_str(); topRev = kv.second; }
      }
      if (topName) { d["topSeller"] = topName; d["topSellerRev"] = topRev; }
    }
    if (!nodeCoins.empty()) {
      JsonObject nodes = d["nodes"].to<JsonObject>();
      for (auto& kv : nodeCoins) nodes[kv.first.c_str()] = kv.second[i];
      JsonObject nsess = d["nodeSessions"].to<JsonObject>();
      for (auto& kv : nodeSess) nsess[kv.first.c_str()] = kv.second[i];
    }
  }
  String json; serializeJson(out, json);
  return response->send(200, "application/json", json.c_str());
}

// ── Income statement (last 3 COMPLETE calendar months) ────────────────────────
// Income by source, per month: vendo from local coin logs; voucher from the REDEMPTION history (every
// voucher sold, named or not) so months before the AUTOGEN naming convention still count. Seller
// commissions come ONLY from AUTOGEN groups × the flat COMMISSION_RATE_PERCENT — so they naturally begin
// the month naming started. Calls: voucher history (income) + voucher groups (commissions) + grid/devices
// (equipment). The client adds the fixed Starlink expense and computes net profit.
esp_err_t handleAdminStatement(PsychicRequest* request, PsychicResponse* response) {
  response->addHeader("Cache-Control", "no-store");
  time_t now = time(NULL);
  int mkNow; { struct tm lt; localtime_r(&now, &lt); mkNow = (lt.tm_year + 1900) * 12 + lt.tm_mon; }
  int mkStart = mkNow - 3;                           // 3 complete months: mkStart .. mkNow-1
  auto monthFirstDay = [](int mk) -> long { return daysFromCivil(mk / 12, mk % 12 + 1, 1); };
  long winStart = monthFirstDay(mkStart), winEnd = monthFirstDay(mkNow);
  auto monthSlot = [&](long day) -> int {            // dayNum → 0..2 relative to mkStart, else -1
    time_t mid = (time_t)(day * 86400 + 43200); struct tm* t = gmtime(&mid);
    int s = ((t->tm_year + 1900) * 12 + t->tm_mon) - mkStart;
    return (s >= 0 && s < 3) ? s : -1;
  };

  // Vendo income per month — local coin logs, no controller call
  long vendo[3] = {}, voucher[3] = {};
  if (fsExists("/vendo_history.json")) {
    File f = LittleFS.open("/vendo_history.json", FILE_READ);
    if (f) {
      while (f.available()) {
        String line = f.readStringUntil('\n'); line.trim();
        if (line.isEmpty()) continue;
        JsonDocument doc;
        if (deserializeJson(doc, line) != DeserializationError::Ok) continue;
        int s = monthSlot(localDayNum((time_t)(doc["ts"] | 0L)));
        if (s >= 0) vendo[s] += (long)(doc["coins"] | 0) * PRICE_PER_COIN;
      }
      f.close();
    }
  }

  // Voucher INCOME per month — redemption history (all vouchers, named or not), from the RAM cache.
  ensureVoucherDays(winStart, winEnd);
  for (long d = winStart; d < winEnd; d++) {
    int s = monthSlot(d);
    auto it = VCHR_DAY_CACHE.find(d);
    if (s >= 0 && it != VCHR_DAY_CACHE.end()) voucher[s] += it->second.second;
  }

  // Seller commission: flat rate (per-seller rates retired 2026-08-09 with sellers.json)
  auto commRate = [](const String&) { return COMMISSION_RATE_PERCENT; };

  // Seller COMMISSIONS per month — AUTOGEN groups only (zero until the naming convention began)
  std::map<String, std::vector<long>> sellerComm;    // seller → per-month commission (size 3)
  JsonDocument groups = getVoucherGroupsJson();
  if (!groups.isNull()) {
    for (JsonObject g : groups["result"]["data"].as<JsonArray>()) {
      String name = g["name"].as<String>();
      if (!name.startsWith("AUTOGEN: ")) continue;
      long long createdMs = g["createdTime"].as<long long>();
      if (createdMs <= 0) continue;
      int s = monthSlot(localDayNum((time_t)(createdMs / 1000)));
      if (s < 0) continue;
      String rest = name.substring(9); int sp = rest.indexOf(' ');
      String seller = sp >= 0 ? rest.substring(sp + 1) : rest;
      int rate = commRate(seller);
      if (rate <= 0) continue;                        // only commissioned sellers are an expense line
      int price = PRICE_PER_COIN;
      JsonDocument dd;
      if (deserializeJson(dd, g["description"].as<String>()) == DeserializationError::Ok)
        price = dd["price"] | PRICE_PER_COIN;
      long rev = (long)g["usedCount"].as<int>() * price;
      auto& v = sellerComm[seller];
      if (v.empty()) v.assign(3, 0);
      v[s] += rev * rate / 100;
    }
  }

  static const char* MN[] = {"January","February","March","April","May","June",
                             "July","August","September","October","November","December"};
  JsonDocument out;
  JsonArray months = out["months"].to<JsonArray>();
  for (int k = 0; k < 3; k++) {
    int mk = mkStart + k;
    JsonObject mo = months.add<JsonObject>();
    mo["label"]   = MN[mk % 12];
    mo["year"]    = mk / 12;
    mo["vendo"]   = vendo[k];
    mo["voucher"] = voucher[k];
    JsonArray sl = mo["sellers"].to<JsonArray>();
    for (auto& kv : sellerComm)                       // only months this seller actually earned commission
      if (kv.second[k] > 0) { JsonObject so = sl.add<JsonObject>(); so["name"] = kv.first; so["commission"] = kv.second[k]; }
  }

  // Real equipment inventory for the Network page (one more controller call — grid/devices)
  JsonArray equip = out["equipment"].to<JsonArray>();
  JsonDocument devDoc = getDeviceGridJson();
  if (!devDoc.isNull())
    for (JsonObject d : devDoc["result"]["data"].as<JsonArray>()) {
      JsonObject e = equip.add<JsonObject>();
      e["type"]  = d["type"]  | "";
      e["model"] = d["model"] | d["showModel"] | "";
      e["name"]  = d["name"]  | "";
    }

  String json; serializeJson(out, json);
  return response->send(200, "application/json", json.c_str());
}

// ── Admin leaderboard ─────────────────────────────────────────────────────────

esp_err_t handleAdminLeaderboard(PsychicRequest* request, PsychicResponse* response) {
  response->addHeader("Cache-Control", "no-store");

  time_t now    = time(NULL);
  int    nDays  = request->hasParam("days")
                  ? (int)max(1L, min(request->getParam("days")->value().toInt(), 365L)) : 30;
  time_t cutoff = now - (time_t)nDays * 86400;

  // Registered sellers from config.json (their home since 2026-08-09); commission is the flat rate.
  std::set<String> registeredSellers;
  {
    File f = LittleFS.open("/config.json", "r");
    if (f) {
      JsonDocument cfg;
      if (deserializeJson(cfg, f) == DeserializationError::Ok)
        for (JsonObject s : cfg["sellers"].as<JsonArray>()) {
          String name = s["name"].as<String>();
          if (!name.isEmpty()) registeredSellers.insert(name);
        }
      f.close();
    }
  }

  // Aggregate usedCount per seller from AUTOGEN groups. Main totals use the `days` window; WoW uses
  // two rolling COMPLETE 7-day windows ending YESTERDAY. Buy-and-use is same-day here, so a group's
  // usedCount settles the day it's created → creation date ≈ redemption date, which makes creation-time
  // week-over-week honest (excluding today's in-progress day). All from the single groups call.
  long todayDay = localDayNum(now);
  std::map<String, std::pair<int,int>> totals;   // seller → {vouchers, revenue}
  std::map<String, long> minTotals;              // seller → minutes sold (used × group duration)
  std::map<String, int> wowCur, wowPrev;         // seller → vouchers this-week / prior-week
  JsonDocument groupsDoc = getVoucherGroupsJson();
  if (!groupsDoc.isNull()) {
    for (JsonObject g : groupsDoc["result"]["data"].as<JsonArray>()) {
      String seller; int price;
      if (!autogenSellerPrice(g, seller, price)) continue;
      long long createdMs = g["createdTime"].as<long long>();
      int used = g["usedCount"].as<int>();
      if (createdMs > 0) {
        long cd = localDayNum((time_t)(createdMs / 1000));
        if      (cd >= todayDay - 7  && cd <= todayDay - 1) wowCur[seller]  += used;   // last 7 full days
        else if (cd >= todayDay - 14 && cd <= todayDay - 8) wowPrev[seller] += used;   // the 7 before
      }
      if (createdMs > 0 && (time_t)(createdMs / 1000) < cutoff) continue;   // main `days` window
      totals[seller].first  += used;
      totals[seller].second += used * price;
      minTotals[seller]     += (long)used * (g["duration"] | 0);
    }
  }

  // Sort by revenue descending
  using SelEntry = std::pair<String, std::pair<int,int>>;
  std::vector<SelEntry> sorted(totals.begin(), totals.end());
  std::sort(sorted.begin(), sorted.end(),
    [](const SelEntry& a, const SelEntry& b){ return a.second.second > b.second.second; });

  JsonDocument out;
  JsonArray arr = out.to<JsonArray>();
  for (auto& kv : sorted) {
    int  comm = COMMISSION_RATE_PERCENT;
    bool reg  = registeredSellers.count(kv.first) > 0;
    JsonObject s = arr.add<JsonObject>();
    s["seller"]     = kv.first;
    s["vouchers"]   = kv.second.first;
    s["revenue"]    = kv.second.second;
    s["commission"] = comm;
    s["net"]        = kv.second.second - (kv.second.second * comm / 100);
    s["registered"] = reg;
    s["wowCur"]     = wowCur.count(kv.first)  ? wowCur[kv.first]  : 0;   // vouchers, last 7 full days
    s["wowPrev"]    = wowPrev.count(kv.first) ? wowPrev[kv.first] : 0;   // vouchers, the 7 before
    s["minutes"]    = minTotals.count(kv.first) ? minTotals[kv.first] : 0;
  }
  String json; serializeJson(out, json);
  return response->send(200, "application/json", json.c_str());
}

// ── Admin config ──────────────────────────────────────────────────────────────

esp_err_t handleAdminConfig(PsychicRequest* request, PsychicResponse* response) {
  response->addHeader("Cache-Control", "no-store");
  if (request->method() == HTTP_GET) {
    String json = maskedConfigJson();
    if (json.isEmpty()) return response->send(500, "text/plain", "Config unreadable");
    return response->send(200, "application/json", json.c_str());
  }
  // POST — merge onto existing config, validate, then write and restart (shared with SoftAP recovery).
  String err;
  if (!mergeAndSaveConfig(request->body(), err))
    return response->send(err.startsWith("Failed") ? 500 : 400, "text/plain", err.c_str());
  response->send(200, "text/plain", "Saved — restarting...");
  delay(500);
  esp_restart();
  return ESP_OK;
}

// ── Admin reboot ──────────────────────────────────────────────────────────────

esp_err_t handleAdminReboot(PsychicRequest* request, PsychicResponse* response) {
  response->send(200, "text/plain", "Rebooting...");
  delay(200);
  esp_restart();
  return ESP_OK;
}

// Reboot every node: broadcast to the slaves (repeated — UDP is lossy), then reboot the master.
esp_err_t handleAdminRebootAll(PsychicRequest* request, PsychicResponse* response) {
  ESP_LOGI(TAG, "Reboot-all requested — broadcasting to slaves");
  for (int i = 0; i < 3; i++) { masterBroadcastReboot(); delay(100); }
  response->send(200, "text/plain", "Rebooting all nodes...");
  delay(200);
  esp_restart();
  return ESP_OK;
}

esp_err_t handleAdminClearVoucherCache(PsychicRequest* request, PsychicResponse* response) {
  VCHR_DAY_CACHE.clear();                                // RAM cache since 2026-08-09
  if (fsExists("/voucher_history.json")) LittleFS.remove("/voucher_history.json");  // legacy file cleanup
  ESP_LOGI(TAG, "Voucher cache cleared by admin");
  return response->send(200, "text/plain", "OK");
}

esp_err_t handleAdminClearErrors(PsychicRequest* request, PsychicResponse* response) {
  if (fsExists("/errors.log")) LittleFS.remove("/errors.log");
  ESP_LOGI(TAG, "Error log cleared by admin");  // INFO → not re-logged to errors.log
  return response->send(200, "text/plain", "OK");
}

// ── GitHub OTA (pull the latest published build over HTTPS) ───────────────────
// Source of truth is the GitHub *Release*: the firmware asset is named firmware-<BUILD>.bin,
// so the build number lives in the artifact itself — no sidecar version.json to drift, and the
// API answers "what's latest" in real time (no Pages CDN lag). jsPDF + the web UI are embedded
// in firmware.bin, so the update is firmware-only; slaves auto-follow via heartbeat afterward.
// NOTE: fetched with setInsecure() (no cert check) — MITM risk, audit S2; real fix is a signed
// firmware image. GitHub's API requires a User-Agent header or it returns 403.
static const char* GITHUB_RELEASES_API = "https://api.github.com/repos/paulkilroy/EllaFi/releases/latest";

struct LatestRelease { int build = 0; String tag; String url; String err; };

// Query the GitHub Releases API for the latest release; parse the firmware-<BUILD>.bin asset.
static LatestRelease fetchLatestRelease() {
  LatestRelease r;
  WiFiClientSecure wc; wc.setInsecure(); wc.setTimeout(12000);
  HTTPClient http; http.setTimeout(12000);
  http.setFollowRedirects(HTTPC_STRICT_FOLLOW_REDIRECTS);
  if (!http.begin(wc, GITHUB_RELEASES_API)) { r.err = "connect failed"; return r; }
  http.addHeader("User-Agent", "EllaFi-OTA");          // required by the GitHub API
  http.addHeader("Accept", "application/vnd.github+json");
  int code = http.GET();
  if (code != 200) { r.err = "HTTP " + String(code); http.end(); return r; }
  String body = http.getString();
  http.end();
  // Filter the (large) response down to just what we need.
  JsonDocument filter;
  filter["tag_name"] = true;
  filter["assets"][0]["name"] = true;
  filter["assets"][0]["browser_download_url"] = true;
  JsonDocument doc;
  if (deserializeJson(doc, body, DeserializationOption::Filter(filter))) { r.err = "parse error"; return r; }
  r.tag = doc["tag_name"].as<String>();
  for (JsonObject a : doc["assets"].as<JsonArray>()) {
    String name = a["name"].as<String>();
    if (name.startsWith("firmware-") && name.endsWith(".bin")) {   // firmware-<BUILD>.bin
      r.build = name.substring(9, name.length() - 4).toInt();
      r.url   = a["browser_download_url"].as<String>();
      break;
    }
  }
  if (r.build == 0 && r.err.isEmpty()) r.err = "no firmware asset in latest release";
  return r;
}

// Streams firmware.bin from a URL into the OTA partition. Returns true on success.
static bool flashFirmwareFromUrl(const String& url, size_t& written, String& err) {
  WiFiClientSecure wc;
  wc.setInsecure();
  wc.setTimeout(20000);
  HTTPClient http;
  http.setTimeout(60000);
  http.setFollowRedirects(HTTPC_STRICT_FOLLOW_REDIRECTS);
  if (!http.begin(wc, url)) { err = "connect failed"; return false; }
  int code = http.GET();
  if (code != 200) { err = "HTTP " + String(code); http.end(); return false; }
  int total = http.getSize();
  if (total <= 0) { err = "unknown content length"; http.end(); return false; }
  if (!Update.begin(total, U_FLASH)) { err = Update.errorString(); http.end(); return false; }
  WiFiClient* stream = http.getStreamPtr();
  uint8_t buf[1024];
  int remaining = total;
  unsigned long lastData = millis();
  while (http.connected() && remaining > 0) {
    int avail = stream->available();
    if (avail > 0) {
      int n = stream->readBytes(buf, min(avail, (int)sizeof(buf)));
      if (n > 0) { Update.write(buf, n); remaining -= n; lastData = millis(); }
    } else if (millis() - lastData > 10000) {
      err = "download stalled"; http.end(); Update.abort(); return false;
    } else {
      delay(1);
    }
  }
  http.end();
  if (remaining > 0) { err = "incomplete (" + String(total - remaining) + "/" + String(total) + ")"; Update.abort(); return false; }
  if (!Update.end(true)) { err = Update.errorString(); return false; }
  written = total;
  return true;
}

static void githubOtaTask(void*) {
  LatestRelease rel = fetchLatestRelease();
  if (rel.url.isEmpty()) {
    ESP_LOGE(TAG, "GitHub OTA: %s", rel.err.length() ? rel.err.c_str() : "no asset URL");
    vTaskDelete(NULL); return;
  }
  ESP_LOGI(TAG, "GitHub OTA: downloading build %d from %s", rel.build, rel.url.c_str());
  size_t written = 0;
  String err;
  if (flashFirmwareFromUrl(rel.url, written, err)) {
    ESP_LOGI(TAG, "GitHub OTA: flashed %u bytes — rebooting (slaves follow via heartbeat)", (unsigned)written);
    delay(1500);
    esp_restart();
  } else {
    ESP_LOGE(TAG, "GitHub OTA failed: %s", err.c_str());
  }
  vTaskDelete(NULL);
}

// GET /admin/github-check → device queries the GitHub Releases API (server-side, avoiding the
// browser CORS block) and compares the latest release's firmware-<BUILD>.bin to its own build.
esp_err_t handleGithubCheck(PsychicRequest* request, PsychicResponse* response) {
  LatestRelease rel = fetchLatestRelease();
  JsonDocument out;
  out["current"]         = (uint32_t)FIRMWARE_BUILD;
  out["latest"]          = rel.build;
  out["version"]         = rel.tag;
  out["updateAvailable"] = rel.build > (int)FIRMWARE_BUILD;
  if (rel.err.length()) out["error"] = rel.err;
  String s; serializeJson(out, s);
  response->addHeader("Cache-Control", "no-store");
  return response->send(200, "application/json", s.c_str());
}

// POST /admin/update-github → kick off the pull-and-flash in a background task.
esp_err_t handleGithubUpdate(PsychicRequest* request, PsychicResponse* response) {
  if (xTaskCreate(githubOtaTask, "GithubOTA", 16384, NULL, 5, NULL) != pdPASS)
    return response->send(500, "text/plain", "Could not start update");
  return response->send(200, "application/json", "{\"ok\":true}");
}

// ── Server setup ─────────────────────────────────────────────────────────────

// TCP keepalive on every accepted socket — reaps dead/half-open connections (a client that vanished:
// moved out of range, powered off, or client-isolated) that close-after-response can't catch, because
// they never complete another request. esp-idf 4.4 has no keep_alive_* config fields, so we set the
// socket options in the accept callback, CHAINING to PsychicHttp's own openCallback (which maintains
// getClientList) so the client-tracking/diagnostic still works.
static httpd_open_func_t g_psychicOpenFn = nullptr;
static esp_err_t keepaliveOpenFn(httpd_handle_t hd, int sockfd) {
  int on = 1, idle = 30, intvl = 5, cnt = 3;   // dead peer dropped after ~30 + 3×5 = 45s of silence
  setsockopt(sockfd, SOL_SOCKET,  SO_KEEPALIVE,  &on,    sizeof(on));
  setsockopt(sockfd, IPPROTO_TCP, TCP_KEEPIDLE,  &idle,  sizeof(idle));
  setsockopt(sockfd, IPPROTO_TCP, TCP_KEEPINTVL, &intvl, sizeof(intvl));
  setsockopt(sockfd, IPPROTO_TCP, TCP_KEEPCNT,   &cnt,   sizeof(cnt));
  return g_psychicOpenFn ? g_psychicOpenFn(hd, sockfd) : ESP_OK;
}

void setupWeb() {
  if (MDNS.begin("ellafi")) {
    ESP_LOGI(TAG, "mDNS started: ellafi.local");
  } else {
    ESP_LOGW(TAG, "mDNS failed to start");
  }

  HTTP_SERVER.config.stack_size       = 16384;
  HTTP_SERVER.config.max_open_sockets = 12;
  HTTP_SERVER.config.lru_purge_enable = true;
  g_psychicOpenFn            = HTTP_SERVER.config.open_fn;   // PsychicHttp's client-tracking openCallback
  HTTP_SERVER.config.open_fn = keepaliveOpenFn;             // wrap it to also enable TCP keepalive per socket

  // Close each HTTP response's socket after it's sent instead of holding it keep-alive. This device has
  // only ~16 LWIP sockets, shared between the 12 web sockets AND every OUTBOUND call (controller login,
  // healthcheck ping). Lingering keep-alive connections from many portal clients pin the pool → outbound
  // starves → OUT OF SERVICE. Closing makes sockets churn (grab → answer → release), like a PisoWiFi ESP.
  // The WebSocket (/ws) is exempt — it must persist for the live coin-insert session.
  HTTP_SERVER.addMiddleware(
    [](PsychicRequest* request, PsychicResponse* response, PsychicMiddlewareNext next) -> esp_err_t {
      esp_err_t r = next();
      if (request->path() != "/ws") {
        PsychicClient* c = request->client();
        if (c) httpd_sess_trigger_close(c->server(), c->socket());
      }
      return r;
    });

  HTTP_SERVER.on("/", HTTP_GET, handleRoot);

  WEBSOCKET_HANDLER.onOpen(handleWsOpen);
  WEBSOCKET_HANDLER.onFrame(handleWsRequest);
  WEBSOCKET_HANDLER.onClose(handleWsClose);
  HTTP_SERVER.on("/ws", &WEBSOCKET_HANDLER);

  HTTP_SERVER.on("/refunds",           HTTP_GET,  handleRefunds)->addMiddleware(adminAuth);
  HTTP_SERVER.on("/admin/activity",    HTTP_GET,  handleActivity)->addMiddleware(adminAuth);
  HTTP_SERVER.on("/errors",            HTTP_GET,  handleErrors)->addMiddleware(adminAuth);
  HTTP_SERVER.on("/program",           HTTP_GET,  handleProgram)->addMiddleware(adminAuth);
  HTTP_SERVER.on("/admin/nodes",       HTTP_GET,  handleAdminNodes)->addMiddleware(adminAuth);
  HTTP_SERVER.on("/admin/recheck",     HTTP_POST, handleAdminRecheck)->addMiddleware(adminAuth);
  HTTP_SERVER.on("/admin/money",         HTTP_GET,  handleAdminMoney)->addMiddleware(adminAuth);
  HTTP_SERVER.on("/admin/money/import",  HTTP_POST, handleAdminMoneyImport)->addMiddleware(adminAuth);
  HTTP_SERVER.on("/admin/money/migrate", HTTP_GET,  handleAdminMoneyMigrate)->addMiddleware(adminAuth);
  HTTP_SERVER.on("/admin/money/migrate", HTTP_POST, handleAdminMoneyMigrate)->addMiddleware(adminAuth);
#ifdef TEST_MODE
  HTTP_SERVER.on("/admin/coinslot/boottest", HTTP_POST, handleCoinBootTest)->addMiddleware(adminAuth);
  HTTP_SERVER.on("/admin/coinslot/boottest", HTTP_GET,  handleCoinBootTest)->addMiddleware(adminAuth);
#endif
#ifdef TEST_MODE
  HTTP_SERVER.on("/diag/hammer",       HTTP_GET,  handleDiagHammer);   // stress repro — see test/crash_hammer.py
#endif
  HTTP_SERVER.on("/admin/log",         HTTP_GET,  handleAdminLog)->addMiddleware(adminAuth);
  HTTP_SERVER.on("/admin/sockets",     HTTP_GET,  handleAdminSockets)->addMiddleware(adminAuth);
  HTTP_SERVER.on("/admin/resources",   HTTP_GET,  handleResources)->addMiddleware(adminAuth);
  HTTP_SERVER.on("/admin/sales",       HTTP_GET,  handleAdminSales)->addMiddleware(adminAuth);
  HTTP_SERVER.on("/admin/statement",   HTTP_GET,  handleAdminStatement)->addMiddleware(adminAuth);
  HTTP_SERVER.on("/admin/leaderboard", HTTP_GET,  handleAdminLeaderboard)->addMiddleware(adminAuth);
  HTTP_SERVER.on("/admin/sellers",     HTTP_ANY,  handleAdminSellers)->addMiddleware(adminAuth);
  HTTP_SERVER.on("/admin/vouchers",    HTTP_ANY,   handleAdminVouchers)->addMiddleware(adminAuth);
  HTTP_SERVER.on("/admin/config",      HTTP_ANY,  handleAdminConfig)->addMiddleware(adminAuth);
  HTTP_SERVER.on("/admin/reboot",             HTTP_POST, handleAdminReboot)->addMiddleware(adminAuth);
  HTTP_SERVER.on("/admin/reboot-all",         HTTP_POST, handleAdminRebootAll)->addMiddleware(adminAuth);
  HTTP_SERVER.on("/admin/clear-voucher-cache", HTTP_POST, handleAdminClearVoucherCache)->addMiddleware(adminAuth);
  HTTP_SERVER.on("/admin/clear-errors",        HTTP_POST, handleAdminClearErrors)->addMiddleware(adminAuth);
  HTTP_SERVER.on("/admin/github-check",        HTTP_GET,  handleGithubCheck)->addMiddleware(adminAuth);
  HTTP_SERVER.on("/admin/update-github",       HTTP_POST, handleGithubUpdate)->addMiddleware(adminAuth);
  HTTP_SERVER.on("/admin",             HTTP_GET,  handleAdminPage);
  HTTP_SERVER.on("/admin/challenge",   HTTP_GET,  handleAdminChallenge);  // unauthenticated — login flow
  HTTP_SERVER.on("/admin/login",       HTTP_POST, handleAdminLogin);      // unauthenticated — login flow
  HTTP_SERVER.on("/admin/logout",      HTTP_POST, handleAdminLogout);
  HTTP_SERVER.on("/sha256.min.js",     HTTP_GET,  handleSha256Js);        // unauthenticated — needed to log in
  HTTP_SERVER.on("/config.json", HTTP_GET, [](PsychicRequest* req, PsychicResponse* res) {
    return res->send(403, "text/plain", "Forbidden");
  });
  HTTP_SERVER.on("/status",     HTTP_GET, handleGetStatus);
  HTTP_SERVER.on("/index.html", HTTP_GET, handleRoot);
  // Per-node brand assets from LittleFS (fall back to baked defaults). Map is 404 when absent →
  // the page just hides the coverage card. theme.css 404→empty so the baked dark theme stays.
  HTTP_SERVER.on("/map.svg", HTTP_GET, [](PsychicRequest* req, PsychicResponse* res) {
    res->addHeader("Cache-Control", "no-store");
    if (!fsExists("/map.svg")) return res->send(404, "text/plain", "");
    File f = LittleFS.open("/map.svg", "r"); String s = f.readString(); f.close();
    return res->send(200, "image/svg+xml", s.c_str());
  });
  HTTP_SERVER.on("/theme.css", HTTP_GET, [](PsychicRequest* req, PsychicResponse* res) {
    res->addHeader("Cache-Control", "no-store");
    if (!fsExists("/theme.css")) return res->send(200, "text/css", "");
    File f = LittleFS.open("/theme.css", "r"); String s = f.readString(); f.close();
    return res->send(200, "text/css", s.c_str());
  });
  setupOtaRoute();
  setupFsOtaRoute();
  HTTP_SERVER.on("/fw.bin", HTTP_GET, handleFwBin);
  HTTP_SERVER.on("/jspdf.umd.min.js", HTTP_GET, handleJsPdf);

  HTTP_SERVER.on("/assets/insertcoinbg.mp3", HTTP_GET, [](PsychicRequest* req, PsychicResponse* res) {
    res->addHeader("Cache-Control", "max-age=86400");
    return res->send(200, "audio/mpeg", (const uint8_t*)web_assets_insertcoinbg_mp3_start, web_assets_insertcoinbg_mp3_end - web_assets_insertcoinbg_mp3_start);
  });
  HTTP_SERVER.on("/assets/coin-received.mp3", HTTP_GET, [](PsychicRequest* req, PsychicResponse* res) {
    res->addHeader("Cache-Control", "max-age=86400");
    return res->send(200, "audio/mpeg", (const uint8_t*)web_assets_coin_received_mp3_start, web_assets_coin_received_mp3_end - web_assets_coin_received_mp3_start);
  });
  HTTP_SERVER.on("/EllaFi.webp", HTTP_GET, [](PsychicRequest* req, PsychicResponse* res) {
    res->addHeader("Cache-Control", "max-age=86400");
    if (fsExists("/logo.webp")) {                 // per-node brand override (binary → read whole; send is synchronous)
      File f = LittleFS.open("/logo.webp", "r");
      size_t n = f.size();
      uint8_t* buf = (uint8_t*)malloc(n);
      if (buf) { f.read(buf, n); f.close(); esp_err_t e = res->send(200, "image/webp", buf, n); free(buf); return e; }
      f.close();
    }
    return res->send(200, "image/webp", (const uint8_t*)web_EllaFi_webp_start, web_EllaFi_webp_end - web_EllaFi_webp_start);
  });
  HTTP_SERVER.on("/favicon.ico", HTTP_GET, [](PsychicRequest* req, PsychicResponse* res) {
    res->addHeader("Cache-Control", "max-age=86400");
    return res->send(200, "image/x-icon", (const uint8_t*)web_favicon_ico_start, web_favicon_ico_end - web_favicon_ico_start);
  });

  HTTP_SERVER.onNotFound(handleNotFound);
  HTTP_SERVER.begin();
  ESP_LOGI(TAG, "Web server started");
}

// ── FreeRTOS tasks ────────────────────────────────────────────────────────────

// Pushes WS status updates to the inserting client.
// Woken immediately by coinPulseTask on each coin (for instant coin count feedback),
// or fires on the 500ms timeout to keep the countdown timer in the UI updated.
// No-op when no session is active.
void updateClientTask(void*) {
  for (;;) {
    xTaskNotifyWait(0, ULONG_MAX, NULL, pdMS_TO_TICKS(UPDATE_CLIENT_INTERVAL_MILLIS));
    if (COIN_INSERT_ACTIVE.load()) pushCoinUpdateToClient();
  }
}

// WebSocketTask: drains PAUSE/RESUME/REFRESH_CACHE jobs posted by WS handlers.
// Pinned to Core 0 — runs alongside PsychicHTTP tasks that enqueue the jobs.
void webSocketTask(void*) {
  WsJob job;
  for (;;) {
    if (xQueueReceive(WEBSOCKET_JOB_QUEUE, &job, portMAX_DELAY) == pdTRUE) {
      if (job.type == JOB_PAUSE)         processPause(String(job.mac));
      if (job.type == JOB_RESUME)        processResume(String(job.mac));
      if (job.type == JOB_REFRESH_CACHE) refreshHotspotSessionCache();
    }
  }
}

void processPause(const String& mac) {
  SessionParams* session = HOTSPOT_SESSION_CACHE.findByMac(mac);
  if (!session) { ESP_LOGI(TAG, "processPause: no session for MAC=%s", mac.c_str()); return; }

  PsychicWebSocketClient* ws = WEBSOCKET_HANDLER.getClient(session->socketFd);  // may be null if WS disconnected
  uint64_t nowMillis = nowEpochMillis();

  if (session->sessionEndMillis == 0 || session->clientId.isEmpty()) {
    if (ws) ws->sendMessage("{\"type\":\"error\",\"subtype\":\"no_session\",\"message\":\"No active session to pause\"}");
    return;
  }
  if (session->sessionEndMillis <= nowMillis) {
    if (ws) ws->sendMessage("{\"type\":\"error\",\"message\":\"No time remaining\"}");
    return;
  }

  unsigned long remaining = (unsigned long)(session->sessionEndMillis - nowMillis);
  ESP_LOGI(TAG, "Pausing client %s with %lu ms remaining", session->clientMac.c_str(), remaining);

  if (!savePausedSessionFile(session->clientMac, remaining)) {
    if (ws) ws->sendMessage("{\"type\":\"error\",\"message\":\"Pause failed\",\"detail\":\"Could not save to filesystem\"}");
    return;
  }

  String errorDetail;
  if (disconnectOmadaClient(*session, errorDetail)) {
    session->pausedRemainingMillis = remaining;
    appendActivityLog("PAUSE", session->clientMac, 0, (int)(remaining / MILLIS_PER_MINUTE));
    if (ws) { ws->sendMessage(buildStatusJson(*session, "paused").c_str()); ws->close(); }
  } else {
    deletePausedSessionFile(session->clientMac);
    if (ws) { ws->sendMessage(("{\"type\":\"error\",\"message\":\"Pause failed\",\"detail\":\"" + errorDetail + "\"}").c_str()); ws->close(); }
  }
}

void processResume(const String& mac) {
  SessionParams* session = HOTSPOT_SESSION_CACHE.findByMac(mac);
  if (!session) { ESP_LOGI(TAG, "processResume: no session for MAC=%s", mac.c_str()); return; }

  PsychicWebSocketClient* ws = WEBSOCKET_HANDLER.getClient(session->socketFd);  // may be null if WS disconnected
  unsigned long pausedRemainingMillis = session->pausedRemainingMillis;

  if (pausedRemainingMillis == 0) {
    if (ws) ws->sendMessage("{\"type\":\"error\",\"message\":\"No paused session to resume\"}");
    return;
  }

  ESP_LOGI(TAG, "Resuming client %s for %d minutes (%lu millis saved)",
           session->clientMac.c_str(), (int)(pausedRemainingMillis / MILLIS_PER_MINUTE), pausedRemainingMillis);

  String errorDetail;
  if (authenticateOmadaClient(*session, (unsigned long long)pausedRemainingMillis, errorDetail)) {
    session->pausedRemainingMillis = 0;
    appendActivityLog("RESUME", session->clientMac, 0, (int)(pausedRemainingMillis / MILLIS_PER_MINUTE));
    deletePausedSessionFile(session->clientMac);
    if (ws) { ws->sendMessage(buildStatusJson(*session, "resumed").c_str()); ws->close(); }
    refreshHotspotSessionCache();  // get updated clientId from Omada
  } else {
    if (ws) { ws->sendMessage(("{\"type\":\"error\",\"message\":\"Resume failed\",\"detail\":\"" + errorDetail + "\"}").c_str()); ws->close(); }
  }
}
