paulkilroy/EllaFi/src/embedded_files.h

#pragma once
#include <stdint.h>

extern const uint8_t web_index_html_start[]              asm("_binary_web_index_html_start");
extern const uint8_t web_index_html_end[]                asm("_binary_web_index_html_end");

extern const uint8_t web_admin_html_start[]              asm("_binary_web_admin_html_start");
extern const uint8_t web_admin_html_end[]                asm("_binary_web_admin_html_end");

extern const uint8_t web_unidentified_html_start[]       asm("_binary_web_unidentified_html_start");
extern const uint8_t web_unidentified_html_end[]         asm("_binary_web_unidentified_html_end");

extern const uint8_t web_assets_insertcoinbg_mp3_start[] asm("_binary_web_assets_insertcoinbg_mp3_start");
extern const uint8_t web_assets_insertcoinbg_mp3_end[]   asm("_binary_web_assets_insertcoinbg_mp3_end");

extern const uint8_t web_assets_coin_received_mp3_start[] asm("_binary_web_assets_coin_received_mp3_start");
extern const uint8_t web_assets_coin_received_mp3_end[]   asm("_binary_web_assets_coin_received_mp3_end");

extern const uint8_t web_EllaFi_webp_start[]             asm("_binary_web_EllaFi_webp_start");
extern const uint8_t web_EllaFi_webp_end[]               asm("_binary_web_EllaFi_webp_end");

extern const uint8_t web_favicon_ico_start[]             asm("_binary_web_favicon_ico_start");
extern const uint8_t web_favicon_ico_end[]               asm("_binary_web_favicon_ico_end");

extern const uint8_t web_jspdf_umd_min_js_start[]        asm("_binary_web_jspdf_umd_min_js_start");
extern const uint8_t web_jspdf_umd_min_js_end[]          asm("_binary_web_jspdf_umd_min_js_end");

extern const uint8_t web_sha256_min_js_start[]           asm("_binary_web_sha256_min_js_start");
extern const uint8_t web_sha256_min_js_end[]             asm("_binary_web_sha256_min_js_end");
