paulkilroy/EllaFi/kicad/sim/board/check_sim_sync.py

#!/usr/bin/env python3
"""Sim-sync checker — board.inc must never silently drift from the schematic.

Exports a fresh netlist from the schematic (kicad-cli) and verifies that every
on-board component modeled in board.inc touches exactly the same nets, using
the net-name mapping below. Connectivity only — orientation of polarized parts
is check_polarity.py's job.

If this fails after a schematic edit: update board.inc (and NETMAP if nets were
renamed), re-run the suite, THEN trust the sim again.
"""
import re, subprocess, sys, os, tempfile

HERE = os.path.dirname(os.path.abspath(__file__))
SCH = os.path.join(HERE, '..', '..', 'EllaFi-PCB.kicad_sch')
KICAD_CLI = '/Applications/KiCad/KiCad.app/Contents/MacOS/kicad-cli'

# KiCad net name -> sim node name in board.inc
NETMAP = {
    '+12V': 'vjack', 'Net-(D6-A1)': 'rail12', '/5V': 'p5v', '/3V3': 'p3v3',
    'GND': '0', '/GPIO4': 'gpio4', '/GPIO14': 'gpio14',
    'Net-(D1-A1)': 'coin', 'Net-(D4-K)': 'nd4k', 'Net-(J1-Pin_3)': 'blink',
    'Net-(J2-Pin_3)': 'j2ret', 'Net-(D3-A)': 'nd3a', 'Net-(D5-A)': 'nd5a',
    'Net-(R2-Pad2)': 'nu1a', 'Net-(U3-EN)': 'en', 'Net-(U3-FB)': 'fb',
}

# schematic ref -> sim element name in board.inc; nets the model deliberately
# omits (subckt-internal grounds, unmodeled switch throw) listed as 'allow_missing'
SIMMAP = {
    'R1': 'r1', 'R2': 'r2', 'R3': 'r3', 'R4': 'r4', 'R5': 'r5', 'R6': 'r6',
    'R7': 'r7', 'R8': 'r8', 'R9': 'r9', 'C1': 'c1', 'C2': 'c2',
    'D1': 'dtv1', 'D3': 'd3', 'D4': 'd4', 'D5': 'd5', 'D6': 'dtv6',
    'F1': 'rf1', 'Q1': 'mq1', 'U1': 'xu1',
    'U3': ('xu3', {'0'}),      # module PGND/AGND are subckt-internal
    'SW1': ('rsw1', {'0'}),    # modeled in the firmware (B-A) position only
}
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
