paulkilroy/EllaFi/(commit log)

2026-03-16 cleaned up logging, shrunk images and change led startup pattern
2026-05-10 connection and timeout fixes
    [coin.cpp, led.cpp, led.h, main.cpp, omada.cpp, omada.h, web.cpp, web.h]
2026-05-27 Multi-node OTA cascade, embedded static files, admin log page
    OTA cascade (master → slave auto-update):
    - UDP heartbeat every 15s; master triggers OTA when slave build < own build
    - Fix: always read full packet body before early returns in networkLoop()
    (partial HeartbeatBody reads left 63 stale bytes, permanently stalling parsePacket)
    - Deauth before esp_restart() in slaveOtaTask prevents UDP-deaf on reconnect
    - Stale-bytes diagnostic: logs WARN if bytes remain in socket before parsePacket
    - Short packet logging; log-clarity pass on all net: Device Log messages
    Static files embedded in firmware (board_build.embed_files):
    - index.html, admin.html, unidentified.html, MP3s, WebP, favicon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
    [partitions_16MB.csv]
2026-05-30 Static files to web/, ring buffer serial fix, WiFi halt, mmap OTA, cloud proxy
    - Move static web files from data/ to web/ — no longer duplicated in LittleFS,
    embedded in firmware only; update platformio.ini embed paths and all _binary_*
    symbols (data_* → web_*)
    - Ring buffer logging: route serial output through Serial.printf in logCore()
    instead of esp_log_write in macros — fixes logs not appearing on serial monitor
    - WiFi connect: replace infinite while-loop with 5-attempt for-loop; halt() on
    failure so LED shows error instead of spinning forever
    - handleFwBin: stream firmware to slaves via esp_partition_mmap (zero-copy,
    no PSRAM allocation); fall back to PSRAM copy if mmap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
    [embedded_files.h, files.cpp, files.h, logger.h, main.cpp, mock_omada.py, network.cpp, network.h]
2026-05-31 setup() refactor: RETRY_ON_FAIL pattern, LED boot sequence, serial log fix
    - Restructure setup() as a series of RETRY_ON_FAIL(setupX()) calls — each
    function returns bool, macro loops with ledError() + 1s delay on failure
    - Move each setup function to its home file: setupFilesystem/setupConfig/setupLogs
    in files.cpp, setupWeb in web.cpp, setupNetwork/setupOmada/setupPins/setupWifi/
    setupNtp/setupTasks all consistently named
    - LED boot sequence: white blink (role unknown) → role-color blink after
    ledRoleKnown() (new LED_NOTIFY_ROLE signal) → solid on ledReady()
    - Fix serial log output: route through Serial.printf in logCore() instead of
    esp_log_write which was unreliable
    - WiF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
    [files.cpp, files.h, led.cpp, led.h, main.cpp, network.cpp, network.h, omada.cpp]
2026-05-31 Browser provisioner: GitHub Pages flasher, release workflow, serial config handler
    - docs/flasher.html: single-file Web Serial provisioner hosted on GitHub Pages.
    Three modes — Fresh Install (flash all 3 binaries + erase LittleFS header +
    provision config), Update Firmware (firmware.bin only), Re-provision (no
    flash, sends FACTORY_RESET then new config over serial). Fetches binaries
    from latest GitHub Release. Requires Chrome/Edge (Web Serial API).
    - .github/workflows/release.yml: builds esp32-s3-devkitc-1-serial on tag push
    (v*) and attaches firmware.bin, bootloader.bin, partitions.bin to the release.
    - setupConfig() now enters a provisioning loop when config.json is absent:
    p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
2026-05-31 Persist network key in localStorage; editable with New Key button
2026-05-31 Fix Transport undefined: switch to ES module import for esptool-js
2026-06-07 Admin: voucher sales, printing, and cleanup fixes
    - Fix voucher counts (Jun 2+): API returns sub-day buckets; was
    overwriting instead of accumulating per day before caching
    - Fix long overflow on today live voucher timestamp (long to long long)
    - Fix multi-page voucher print: cached page-1 codes blocked fetchAllCodes
    from fetching remaining pages; now only cached when batch is 1 page
    - Add Clear Voucher Cache button (System tab) + /admin/clear-voucher-cache
    - Voucher panel: blue loading bar + all buttons greyed during generate,
    load, and print operations via setVoucherBusy()
    - Fix duplicate extern PRICE_PER_COIN in globals.h
    - Fix missing h.end() on all HTTP error paths in omada.cpp (1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
    [coin.cpp, coin.h, files.cpp, files.h, globals.h, main.cpp, mock_omada.py, network.cpp]
2026-06-07 Add test scripts: cloud_proxy and probe_voucher_history
2026-06-07 Voucher delete, used/total display, WiFi auto-reconnect
    - Add deleteVoucherGroup() to omada.cpp + DELETE /admin/vouchers?id=
    - Voucher table: replace Pages column with used/total count (used in blue)
    - Add usedCount to GET /admin/vouchers response
    - Delete button per voucher batch row with confirm dialog
    - WiFi auto-reconnect: call WiFi.reconnect() when status != WL_CONNECTED
    in networkLoop() health check — fixes stall after AUTH_LEAVE/ASSOC_LEAVE
    [network.cpp, omada.cpp, omada.h, web.cpp]
2026-06-11 Coin-session single-owner refactor + timezone-aware reports (v1.3.0)
    Major refactor: coin session is now owned by a single FreeRTOS task
    (coinSessionTask), replacing the mutex + binary-semaphore + software-timer
    trio. Client ip and WS fd are fused into one CAS-able atomic slot, closing
    the torn-binding race on reconnect.
    Reports:
    - Day-bucketing in controller-local time. Timezone resolved at startup from
    GET settings/system/status via an IANA->POSIX table (DST-aware). Fixes
    END-stamped voucher buckets being attributed one day late.
    - Sales chart extended to 90 days.
    Admin dashboard:
    - Controller status row (online/offline, model/version, uptime, clock skew),
    cached from settings/syst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
    [coin.cpp, coin.h, files.cpp, globals.h, log_buffer.cpp, main.cpp, mock_omada.py, network.cpp]
2026-06-11 Flasher: read-device-MAC button + Linux serial troubleshooting
    - "Read from device" button next to Master Node MAC reads the chip MAC over USB
    (esptool-js), colon-formatted to match WiFi.macAddress(); fills master_mac only
    after a confirmation popup ("set THIS device as master?") — never silently
    - Collapsible Linux help: finding the port (ttyUSB/ttyACM, ls /dev/serial/by-id),
    and "failed to open serial port" fixes (ModemManager/brltty, chmod, dialout)
2026-06-11 Voucher PDF + one-tap GitHub update (v1.3.1)
    Voucher printing:
    - Generate a real A4 PDF client-side with jsPDF (embedded in firmware, served from
    flash at /jspdf.umd.min.js) instead of window.print(). Exact 5x26 = 130/page on
    iPhone/Android/desktop — a PDF page is atomic, so AirPrint scales it whole instead
    of reflowing/dropping rows. WebP logo rasterized to PNG via canvas for jsPDF.
    Update from GitHub (admin System tab):
    - GET /admin/github-check: device fetches version.json from GitHub Pages (server-side,
    avoids github.io CORS) and compares build numbers.
    - POST /admin/update-github: background task streams firmware.bin over HTTPS into the
    OTA partition, flashes, reboots; slav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
    [embedded_files.h, globals.h, web.cpp]
2026-06-11 Logging audit: keep the error log signal-only (v1.3.2)
    The error log captures W/E (and forwards slave W/E to the master), so several
    expected/normal events were flooding it. Downgraded to INFO (still in the live
    dev log, just not the error log):
    - coin pulse trace + boot-suppression notice (per-pulse flood)
    - 404 "unexpected host" — captive-portal probes from every client device
    - duplicate bad-PSK UDP warning collapsed to one INFO line
    - OTA "build < mine" trigger + "fw_size=0" — fire every ~15s per stale slave
    - "Auth result not delivered (client disconnected)" — auth still succeeds
    - portal "no MAC"/"no cached session"/pause-resume "no session" — client churn
    - "Replacing stale c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
    [coin.cpp, globals.h, network.cpp, omada.cpp, web.cpp]
2026-06-11 Fix version.json: read build/version from tag, not master [skip ci]
    CI generated version.json AFTER `git switch -C master`, so it read globals.h from
    master (which can lag the tag) — v1.3.2 shipped {build:40} while firmware.bin was
    correctly build 41, so the device saw "up to date" instead of an update. Read
    BUILD/VERSION before the switch, and correct the live version.json to 41/1.3.2.
2026-06-11 OTA via GitHub Releases API (filename carries the build) (v1.3.3)
    Replace the version.json sidecar with the GitHub Releases API as the single source
    of truth: the firmware asset is named firmware-<BUILD>.bin, so the build number lives
    in the artifact — nothing to drift, and the API reports "latest" in real time (no Pages
    CDN lag). Removed the two version.json bug classes (stale-read, lag) by construction.
    - Device: /admin/github-check queries the Releases API (with required User-Agent),
    parses tag_name + the firmware-<BUILD>.bin asset name; /admin/update-github downloads
    that asset (follows the github.com→objects.githubusercontent.com redirect) and flashes.
    - Admin poll now watches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
    [globals.h, web.cpp]
2026-06-11 Fix multi-node OTA: serve true image size + one worker at a time (v1.3.4)
    The slave self-update looped forever. Three linked causes:
    1. Truncated image (root cause). The master served fw_size from NVS, which is only
    written by the web /update and GitHub-OTA paths — a serial flash never updates it.
    So a serial-flashed master served the *previous* build's length of its current
    partition, and the slave's Update.end() rejected the short image ("Could Not
    Activate The Firmware"). Now we serve ESP.getSketchSize() (esp_image_verify's
    image_len, incl. the appended SHA), captured once at boot into RUNNING_IMAGE_SIZE.
    The stale fw_size NVS value is deleted entirely (all reads + bo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
    [globals.h, main.cpp, network.cpp, web.cpp]
2026-06-14 Pre-launch hardening: HMAC mesh, graceful degradation, admin auth, log/session fixes (v1.3.6)
    Authenticated multi-node mesh:
    - HMAC-SHA256 over every UDP packet (replaces the cleartext PSK), timestamp
    freshness window, and a coin-replay ring; C4 socket mutex serializes UDP access.
    - Multi-node OTA serves the running image size; one worker at a time.
    Session cache (C2):
    - MAC-keyed cache (non-destructive on a client re-IP); mergeClientLists reads the
    live WiFi-client IP, fixing pause "IP=null" against a faithful mock.
    Graceful degradation:
    - Web server starts first; NTP/Omada best-effort with background retry; isServiceReady()
    gates selling; out-of-service red LED + dashboard banner;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
    [use1-api-omada-controller-connector-tplinkcloud-com.openapi.yaml]
2026-06-14 Bump to v1.3.7 / build 46
    Distinct build number for the pre-launch hardening stack — build 45 was reused
    across several post-flash code changes, so OTA/slave comparison needs a fresh number.
2026-06-14 Fix daily reboot to local time; consolidate roadmap into TODO.md
    - main.cpp: scheduled 3am reboot used gmtime() → fired 3am UTC = 11am PHT (peak).
    Use localtime() so it honours the controller-set TZ (UTC+8) and hits a dead hour.
    - Consolidate TODO.md + enhancements.md + open audit items into one TODO.md
    (single source of truth); reference the design specs + test plan rather than
    duplicating them. Add: README rewrite, Omada config helper/analyzer.
    - Remove the redundant memory/enhancements.md (folded in). The detailed audit
    stays gitignored (exploit detail out of the public repo); TODO carries terse items.
    [main.cpp]
2026-06-15 Ship v1.3.7 (build 47): reboot/uptime fixes, Reboot All, node alias storage
    Field is still on v1.3.4 — this tags and releases the 1.3.5->1.3.7 work that
    was committed but never tagged, plus the build-47 batch.
    - 3am reboot: master uses localtime (was 3am UTC = 11am peak); slaves gated
    off self-reboot and cycled via new "Reboot All" button (NET_MSG_REBOOT, HMAC'd);
    "Reboot ESP32" -> "Reboot Master".
    - Dashboard uptime: fix duplicate fmtUptime rendering node seconds as ms.
    - Device Log: remove broken Clear button; color the W/I/D level filters.
    - Node nickname+commission stored on the controller via setClientName PATCH
    (each node is a client; name = "nickname|commission"), read back f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
    [globals.h, main.cpp, mock_omada.py, network.cpp, network.h, omada.cpp]
2026-06-15 v1.3.8 (build 48): 3am reboot cascades to slaves
    The master's scheduled 3am-local reboot now broadcasts NET_MSG_REBOOT to the
    slaves (3x, mirroring "Reboot All") before restarting itself, so the whole
    village cycles together. Previously only the master rebooted; slaves never
    auto-restarted (no TZ, gated off self-reboot) — they only cycled via the manual
    "Reboot All" button.
    [globals.h, main.cpp]
2026-06-16 v1.3.9 (build 49): on-demand controller re-check from the dashboard
    Controller status (reachable / serviceReady) was only refreshed on coin/session
    events, so a controller that died while idle went unnoticed — selling stayed
    "enabled" and the out-of-service banner never appeared.
    - New POST /admin/recheck forces one refreshControllerStatus() on demand.
    - refreshControllerStatus() is now bounded (4s connect/read) so it can't stall,
    and on failure it forces a re-login so recovery is prompt even after a
    controller restart (the session is cached for an hour otherwise).
    - Dashboard forces a fresh check on open (non-blocking) so an idle controller
    death surfaces the moment you look; the r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
    [globals.h, omada.cpp, omada.h, web.cpp]
2026-06-16 Hardware design review (verified against KiCad netlist + PCB)
    Reviewed ~/Documents/EllaFi-PCB against the live netlist. Schematic checks out
    (Q1 gate pulldown, LM2596 ON/OFF+FB, opto 3V3/220R input, D1 TVS placement all
    correct). Documents the 2-wire/3-wire J2/SW1 panel modes and the coin-pulse
    path (always J1.2 -> opto -> GPIO4; loop completes only when Q1 is enabled).
    Fix stale firmware comments (comment-only, no functional change):
    - COINSLOT_POWER_PIN: IRF540N -> IRLZ44N (logic-level, matches the BOM/board)
    - coin slot pin: GPIO5 -> GPIO4 (matches the define)
    - opto is NOT galvanically isolated here (LED anode on board 3V3, shared GND) —
    corrected to "band-limits the spike," which i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
    [coin.cpp, globals.h]
2026-06-16 Comment the GPIO4 coin-pulse / Q1-enable hardware coupling
    A coin pulse only reaches COINSLOT_PIN (GPIO4) while COINSLOT_POWER_PIN is HIGH,
    because the acceptor's GND return runs through the Q1 low-side switch — documents
    why no pulses appear when the acceptor is disabled.
2026-06-17 v1.3.10 (build 50): Healthchecks.io ping + fix the v1.3.9 /admin/recheck crash
    - Healthchecks.io master dead-man's switch: POST {mac,uptime_s,active_sessions}
    every 60s when healthchecks_url is set (config + admin Settings field). Catches
    the one failure the device can't self-report — the master itself dying.
    - FIX (v1.3.9 field regression): /admin/recheck did a blocking controller-login
    TLS on the esp_http_server thread, fired on every dashboard open and racing the
    loop's setupOmada retry + the WS refresh while the controller was down — that
    concurrency corrupted CREDS_MUTEX and tripped a FreeRTOS assert (crash loop).
    Now it enqueues the refresh on the WebSocketTask and retu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
    [files.cpp, globals.h, main.cpp, web.cpp]
2026-06-18 Fix heap-clean mutex corruption: create CREDS_MUTEX once (v1.3.11)
    setupOmada() doubles as the 30s controller-down retry in loop(), and it
    re-created CREDS_MUTEX on every call. A task holding the old semaphore while
    the global was swapped to a fresh one let a second task enter the critical
    section — the heap-clean "double owner" that tripped
    `assert failed: xQueueGenericSend queue.c:832` whenever the controller was down.
    Fix: create the lock exactly once (if (CREDS_MUTEX == nullptr) ...).
    Also: correct the handleAdminRecheck comment — the v1.3.10 offload only
    narrowed the race window, it was not the cause — and add a TEST_MODE-gated
    /diag/hammer stress endpoint + test/crash_hammer.py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
    [crash_hammer.py, globals.h, omada.cpp, web.cpp]
2026-06-18 Fix LittleFS-corruption crash: patch WiFiClientSecure double-close(0) (v1.3.12)
    The second outage crash (a `lfs_mlist_isopen` assert in LittleFS): on a failed TLS connect,
    WiFiClientSecure::connect() calls stop(), and ssl_client.cpp stop_ssl_socket() memsets the
    sslclient_context to 0 — clobbering the socket fd to 0 instead of -1. The HTTPClient destructor
    then calls stop() again, sees `0 >= 0`, and does close(0): it closes stdin, LittleFS recycles
    fd 0, and the next close(0) corrupts a LittleFS file → assert/crash.
    Confirmed by instrumenting wc.fd() (read 0 after a failed POST, heap CLEAN — not corruption).
    Fix: vendor WiFiClientSecure into lib/ and restore `socket = -1` after the me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
    [globals.h]
2026-06-19 Pin platform to espressif32@6.5.0 + document the WiFiClientSecure patch
    lib/WiFiClientSecure/ carries a one-line fix — ssl_client.cpp stop_ssl_socket() restores socket = -1
    after the upstream memset, preventing the failed-connect double-close(0) that corrupted LittleFS
    (shipped v1.3.12). That vendored copy depends on the framework's mbedTLS + sslclient_context layout, so
    pin the platform (Arduino-ESP32 2.0.14) to keep them in sync — an unattended bump could silently desync
    the patch. Documented the patch, the pin rationale, and the bump procedure at the top of platformio.ini.
    A BearSSL migration (ESP_SSLClient + ArduinoHttpClient) to retire the vendored lib was attempted and
    rejected: i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
2026-06-19 v1.3.13: admin auth middleware, node "down for" reporting, deps cleanup
    - Admin auth → PsychicHttp middleware: `adminAuth` (isAuthorized + 401) attached via ->addMiddleware()
    to the 17 protected routes; removed the 17 in-body checkAdminAuth() calls. Auth model unchanged
    (cookie token, IP-bound, TTL) — the policy is now visible in the route table instead of buried in each
    handler. Verified on hardware: 401 on protected (GET + destructive POSTs), 200 on open/login routes.
    - Node-health UI: offline nodes show "(down Xm)" (time since last heartbeat) and dash the stale RSSI;
    last-known version kept (forensics for "did an OTA brick it?").
    - Dropped the now-unused ESP_SSLClient dep —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
2026-06-19 Clean up TODO: close out the crash saga + BearSSL dead-end
    - 🔴 near-term cleared (crash work done, details in Done)
    - BearSSL migration moved to Cancelled (condensed from the verbose Resilience entry)
    - C5 (LittleFS multi-task writes) marked resolved — the soaks validated it; the asserts were the
    close(0) fd bug, not concurrency
    - dropped stale (NEW) tags
2026-06-19 Add test/calibrate_delays.py — derive mock DELAYS (p50/p90) from a live-controller serial log
    Pairs each Omada op's start (POST/GET <url>) with its finish (… successful / HTTP …) using the device
    millis() timestamps, buckets by op, prints a paste-ready DELAYS block. Calibration itself is pending a
    live-controller capture (must be local for the coin flow); noted the remaining step in TODO.
2026-06-22 Hardware TODO: save a reference board layout for rev-B shape/form-factor
2026-06-23 v1.3.14: persistent admin sessions + mock --cloud OAuth fix
    Firmware:
    - Admin sessions persist until browser close / daily reboot. The cookie is
    now a pure session cookie (no Max-Age) and isAuthorized() no longer checks
    expiry; ADMIN_SESSION_TTL_MS is repurposed as a slot-reclaim window so the
    fixed ADMIN_SESSIONS array still self-heals.
    - Bump FIRMWARE_VERSION 1.3.14 / build 54.
    Tooling:
    - mock_omada --cloud: step 3 (oauth/authorize) now authorizes with the
    omada-cloud-portal client + a self-generated state nonce, NOT the login
    response's unified_id redirectParams — the inner-SSO code was rejected by
    login-with-uid-code as -52054. code/state/serviceUrl all come from the
    aut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
    [globals.h, mock_omada.py, web.cpp]
2026-06-23 Design: field WiFi re-provisioning (SoftAP, button-armed)
    Agreed design for no-USB on-site recovery when a node falls off WiFi:
    bespoke SoftAP (not BLE — same protocomm security, no BLE flash cost), armed
    by holding the internal GPIO0 boot button ~3s while the LED is solid red
    (disconnect state). Locked-box physical gate, so no PoP by default
    (security1/NULL — encrypted channel; optional provisioning_pop). 5-min window,
    creds -> config.json -> reboot. Also adds the AP coverage-map TODO entry.
    Not yet implemented — see memory/field_reprovisioning_design.md.
2026-06-24 Field WiFi re-provisioning: SoftAP captive-portal recovery
    A node that can't join WiFi with stored creds no longer hard-loops in
    RETRY_ON_FAIL forever. setup() now escapes to runWifiRecovery():
    - solid red LED; retries stored creds every 10s and reboots on success
    (transient self-heal)
    - BOOT button (GPIO0) held 3s arms an open SoftAP "EllaFi-Setup-<MAC4>"
    with a wildcard DNS captive portal (auto-popup, no IP to type, no app)
    - the portal serves the full pre-filled/password-masked config form; saving
    merges + reboots. Blue blink armed / solid blue connected; 5-min idle, 15-min cap.
    Physical (locked-box) gate only — the arming button is inside the enclosure
    and anyone with it open co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
    [files.cpp, files.h, led.cpp, led.h, main.cpp, reprovision.cpp, reprovision.h, web.cpp]
2026-06-25 v1.3.15: field WiFi re-provisioning + form charset fix
    Bump to 1.3.15 / build 55. Adds <meta charset='utf-8'> to the SoftAP config
    form so the masked-password placeholder (••••••••) renders correctly and
    round-trips — without it the browser could mangle the bytes and overwrite a
    secret with garbage when an unchanged field was submitted.
    [globals.h, reprovision.cpp]
2026-06-30 v1.4.0: AP coverage map + config environments + branding/preview
    Minor bump (1.4.0, build 56): config.json gains an environments/active_env
    structure (back-compatible with old flat configs). web + LittleFS changed →
    slaves pull the new filesystem on next heartbeat.
    AP coverage map (customer captive page): firmware snapshots every Omada device
    as {mac:status} (gated on /map.svg existing) and pushes it in /status + /ws;
    the page fetches /map.svg, matches dots by data-mac, colors green/amber/red.
    The map is per-node LittleFS data, generated by tools/build_site_map.py from a
    Google My Maps URL/KML (MAC in each pin's description) + OpenStreetMap geometry
    — firmware stays generic, no AP confi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
2026-07-25 AP map: send device status to no-session clients + fix page load-order race
    Two bugs kept the captive-page AP coverage map all grey:
    1. /status only included "devices" when the client had an active hotspot
    session. Anyone viewing the map before paying (most captive-page viewers)
    got the no-session fallback with no devices, so dots were never colored.
    AP status is global, not per-session — always include it.
    2. Page race: fetchStatus() (small) resolved before loadMap() injected the
    11KB SVG, so updateAps() painted a DOM with no dots yet and the colors
    were lost, with no repeating poll to re-apply. Remember the last device
    status and re-apply it after the SVG loads.
    Co-A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
    [web.cpp]
2026-07-25 Revenue: coin pulses are currency units; sales tab 12-month + WoW
    The acceptor emits 1 pulse per currency unit (1 pulse = ₱1, a ₱5 coin = 5
    pulses), so the internal coin count is already the peso total. Multiplying by
    price_per_coin=5 inflated coin revenue 5×. Default price_per_coin to 1 so the
    multiplier is a no-op; it stays configurable for the day the acceptor is set to
    N pulses per coin. Keep the generic "coin" wording (not peso-bound).
    Voucher revenue reused price_per_coin as its no-amount fallback, which would
    have silently dropped 5× too. Split it into FALLBACK_PRICE_PER_VOUCHER
    (default 5) so historic voucher estimates are unchanged.
    Sales tab (carried from prior session): 12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
2026-07-25 mock: grid/devices endpoint, --cloud-env, environment overlay
    - Add GET /sites/{id}/grid/devices — returns synthetic MOCK_DEVICES (offline)
    whose MACs match data/map.svg, or forwards to the real controller under
    --cloud, so the AP coverage map works locally.
    - Apply the config environments{} overlay (mirrors firmware loadConfig) before
    cloud auth — omada_controller_id now lives under active_env, not top level;
    without this --cloud KeyErrored.
    - Add --cloud-env NAME to pick which environment to pull cloud creds from,
    decoupled from active_env.
    - Clearer errors: missing-key names the env, unknown env lists the available
    ones, and cloud-auth step 5 lists the registered controlle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
    [mock_omada.py]
2026-07-25 Node-down alerting: fold coin-node health into the master healthcheck
    The existing healthchecks.io ping is a dead-man's switch on the MASTER's own
    liveness — it can't catch a slave going down (the master keeps pinging). Now
    the master scans known nodes each minute and, if any has missed ~4 heartbeats
    (NODE_OFFLINE_THRESHOLD_MILLIS, shared with the admin "online" dot so they
    agree), POSTs to {healthchecks_url}/fail with the down MAC(s) instead of a
    success ping. One generic alert fires; the operator opens /admin to see which
    node. A dead master trips it too (it stops pinging entirely). No new config.
    [globals.h, main.cpp, web.cpp]
2026-07-25 Income statement: downloadable monthly P&L PDF on the Sales tab
    For income substantiation (visa/government). New GET /admin/statement returns,
    for the last 3 complete months: vendo income (local coin logs), voucher income
    and per-seller commission (one voucher-groups call + sellers.json rates), and
    the real equipment inventory (grid/devices). Extracted getDeviceGridJson() so
    the AP-map poller and the statement share one device fetch.
    Client (admin.html) builds a jsPDF document reusing the voucher PDF's loader +
    logo: one page per month (INCOME - EXPENSES = NET PROFIT, sellers itemized,
    editable Starlink line), plus a Network Infrastructure page with the auto
    equipment list, live AP names, a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
2026-07-25 Income statement: voucher income from redemption history, not named groups
    Voucher income was sourced from AUTOGEN groups, so any sale made before the
    seller-naming convention started (pre-June) counted as zero. Pull voucher
    income from the redemption history instead (every voucher sold, named or not);
    keep the named groups solely for per-seller commissions, which then correctly
    begin the month naming started. Empty commission months render as "(none)".
    [web.cpp]
2026-07-25 Firmware v1.4.1 (build 57): voucher-active counts connected clients; static-IP override; PSRAM client-list parse
    - Voucher active: count clients CURRENTLY CONNECTED via voucher (allDoc authInfo.authType==3), not hotspot end>now — which counted never-expiring By-Usage sessions (191 vs actual ~35).
    - Static IP: optional config static_ip (+ static_gateway/subnet/dns), applied via WiFi.config() before WiFi.begin(); empty = DHCP; just-the-IP defaults gateway=<ip>.1, /24, DNS=gateway.
    - omada: parse large (chunked) client lists via getString()+JsonDocument(&psramAlloc) — fixes DRAM OOM (-32512 / 68KB parse failure).
    [files.cpp, globals.h, main.cpp, omada.cpp]
2026-07-25 docs/memory: MPM3620A buck + J4/J5 socket state; profiles-groups API capture; gitignore local backups
2026-07-25 Firmware v1.4.2 (build 58): fix Sites re-login loop + healthcheck ping over plain HTTP
    - loadOmadaSites: on non-200 or empty body, invalidate the session so the next retry re-logins, instead of looping every 30s on a misleading 'JSON parse error'.
    - pingHealthcheck: use plain HTTP (WiFiClient) instead of TLS. The dead-man's-switch ping needs no TLS, and dropping the ~40KB handshake stops it starving internal DRAM when the Omada refresh task is mid-handshake — the cause of the intermittent 'HTTP -1' failures.
    [globals.h, main.cpp, omada.cpp]
2026-07-25 deploy.py: authenticate via challenge-response login, not HTTP Basic
    The device's admin gate is cookie-only (isAuthorized checks the ellafi_admin session cookie), so Basic auth silently failed the OTA. deploy.py now does GET /admin/challenge -> sha256(nonce:password) -> POST /admin/login and carries the session cookie on the uploads, re-logging in after the FS-flash reboot.
2026-07-30 hardware: bring the KiCad board into the repo (kicad/, source only)
    Moved EllaFi-PCB from ~/Documents/EllaFi-PCB into the repo. Source files only — gerbers/drill/BOM/backups gitignored, regenerate on demand. Lib tables use ${KIPRJMOD} so they stay portable.
    Captures the current board state: MPM3620A buck redesign, J4/J5 ESP socket wiring (5V/3V3/GPIO4/GPIO14), the GPIO4->3V3 short fix, and net-class colours (GND black, 5V red, 3V3 red-dash, 12V red-thick, coin signals blue/orange).
    [EllaFi-PCB.kicad_pcb, EllaFi-PCB.kicad_sch]
2026-07-30 kicad: extend net-class colours through the current-limit resistors
    Coin-pulse line Net-(D1-A2) (J1.2/D1/opto cathode) -> blue; 3V3 red-dash continued past R2/R5 to the opto-LED and D5 anodes; 5V solid-red continued past R3/R4 to the D3/D4 anodes.
2026-07-30 kicad: schematic wire/label cleanup + fix .gitignore inline-comment bug
    Merged the J5.21/GND-area wires and nudged a label. Also fixed kicad/.gitignore — inline comments were being parsed as part of the pattern, so *.kicad_prl and *-backups/ never matched.
    [EllaFi-PCB.kicad_sch]
2026-07-31 sim: validate MPM3620A kills the LM2596 input spike (ngspice)
    Same VIN-spike test on both: LM2596 rings 30.3V/-7.3V (over the module's 28V abs-max), MPM3620A sits at 12.1V/11.8V (0.24V ripple) — the switch/inductor/input-cap are on-die so the external pin never sees the di/dt. Sources in kicad/sim/; result recorded in hardware_notes.
2026-07-31 kicad: PCB fully routed + DRC-clean (buck complete)
    MPM3620A buck routed (FB on top layer, no via; grounds via'd to the plane), J3/F1/D6 input front-end, coin/signal nets, GND pours filled. Net-class track widths 0.25mm. DRC: 0 unconnected, 0 violations. Buck spike test passes (12.1V vs LM2596's 30.3V).
    [EllaFi-PCB.kicad_pcb]
2026-08-06 kicad: whole-board validation suite + fix 4 sim-found defects
    New kicad/sim/board/ (./run_all.sh): pad-polarity checker (board vs
    datasheet intent), sim-sync checker (SPICE model vs fresh netlist
    export), 11 ngspice scenario benches + 60-trial Monte Carlo.
    Defects the suite found, fixed in schematic+PCB:
    - D4 saw 7V reverse (5V-max LED) whenever Q1 off -> moved with R4 to
    the gate side; also now clamps GPIO14 during boot vs pullup panels
    - reversed adapter put -12V on the buck -> D6 1.5SMC18CA (bidir) ->
    1.5SMC18A (unidir), band to 12V rail; clamps -0.8V, F1 trips
    - D1 coin-line TVS installed backwards (band on GND -> would clamp
    the coin line at 0.7V; dead coin input) -> flipped
    - lo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
    [EllaFi-PCB.kicad_pcb, EllaFi-PCB.kicad_sch]
2026-08-08 kicad/sim: firmware-in-the-loop co-simulation (day-in-the-life + pitik attack)
    Layer 1: tb_dayinlife.cir (4.5s: ripple, boot, brownout, dropout, bouncy
    coin, jammed inserts, post-session coin) + tb_attack_zoom.cir (100ns-step
    piezo spark via coin wire AND direct trace pickup). Layer 2:
    cosim_replay.py replays coin.cpp's verbatim ISR/task semantics (constants
    parsed live from globals.h, ratiometric pin thresholds, 2.8V brownout
    reset) over the SPICE waveforms and verdicts against ground truth.
    cosim_scope.py renders the annotated virtual-scope dashboard.
    Findings recorded in TODO.md (separate commit): worn-acceptor bounce can
    trip the 3-strike fraud abort (no field evidence yet — monitor,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
    [cosim_replay.py, cosim_scope.py]
2026-08-08 admin: per-node coin-reject counters ("Rejects" column) + log text filter
    Acceptor-health observability, chosen over changing the fraud logic (no
    field evidence of the bounce failure mode; width check has proven pitik
    value). Counters (width/interval, since boot = "today" via the 3am
    reboot) increment at the two reject sites, ride the heartbeat (+4 bytes
    - mixed-build fleets show un-updated slaves as down until they OTA), and
    render as an amber count in the node table; click jumps to the Device
    Log pre-filtered to "fraud" (new general-purpose text filter). Durable
    history stays errors.log, which already receives slave-forwarded E/W
    lines - no boot-time log parsing.
    TODO.md: boot-glitch char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
    [coin.cpp, globals.h, main.cpp, network.cpp, network.h, web.cpp]
2026-08-09 coin: acceptor boot-glitch characterization endpoint (+ measured result)
    POST/GET /admin/coinslot/boottest cycles Q1 N times (default 20: 2s off,
    3s capture) and records every raw pulse the ISR queues - before the
    suppress/width/interval filters, which are untouched. coinPulseTask
    stays the queue's sole consumer and diverts pulses to the capture buffer
    while the test runs; session claims are refused during a run.
    Measured on the bench CH-926: 40 power-ons over two days (incl. an
    overnight-cold start), zero pulses, zero stuck-low windows - power-on is
    clean on this unit. COINSLOT_BOOT_SUPPRESS_MILLIS stays 500ms as margin;
    rerun at new-board bring-up and per new acceptor. Build 59 -> 60.
    Co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
    [coin.cpp, coin.h, globals.h, web.cpp]
2026-08-09 money: NVS financial ledger wired + history migration (build 61)
    Wires money_store (was unreferenced): moneyStoreBegin at boot; nightly
    rollup at 2:45am (before the 3am reboot) upserting live AUTOGEN voucher
    groups at the flat COMMISSION_RATE_PERCENT (20), freezing vanished
    groups only on a successful fetch, refreshing income months (vendo from
    the sale log, voucher from the ledger). Endpoints: GET /admin/money
    (record + backup export), POST /admin/money/import (Mac rollup merge),
    GET/POST /admin/money/migrate (one-time vendo-history migration with
    dry-run + NVS guard). moneyImport income merge now field-preserving so a
    voucher-only rollup cannot zero vendo months.
    PRESERVE[] now keeps vend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
    [globals.h, main.cpp, money_store.cpp, money_store.h, web.cpp]
2026-08-09 storage simplification: sellers -> config.json, voucher cache -> RAM (build 62)
    sellers.json deleted (config.json "sellers" is the one home; Settings
    posts merge via mergeAndSaveConfig; node nicknames/commissions were
    already controller-backed - no local fallback, blank while controller
    down + cache cold). Per-seller commission rates retired: flat
    COMMISSION_RATE_PERCENT everywhere.
    voucher_history.json deleted: it was a pure day-bucket cache of the
    Omada statistics API - now a RAM map shared by the sales + statement
    handlers, lazily refilled with one ranged fetch per window after each
    nightly reboot (first load ~1.6s, cached 0.5s, verified live). Clear
    button clears the RAM map.
    PRESERVE[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
    [globals.h, main.cpp, web.cpp]
2026-08-11 diag: contention instrumentation for healthcheck + client-list parse (build 63)
    Healthcheck failures now log a contention snapshot: elapsed ms (instant
    connect/DNS fail vs 4s timeout), Omada TLS-in-flight count (TlsGuard
    RAII on all 15 WiFiClientSecure sites - the ~40KB DRAM competitor), WS
    job queue depth, RSSI, free internal DRAM + largest block. Uniform
    tls=0/healthy-heap failures = WAN loss; correlated tls>0 or collapsed
    largest-block = firmware contention. Measure before fixing.
    getAllClientsJson parse errors (seen once 2026-08-10 with errorCode:0
    prefix) now log deserialization error name, body length vs
    Content-Length (truncation proof), and largest DRAM block.
    Build 62 -> 63.
    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
    [globals.h, main.cpp, omada.cpp, omada.h]
2026-08-12 kicad/sim: electrical microscope — switching-level buck in-circuit + us-scale opto/pin edges, multi-decade visual (tb_microscope.cir + microscope_scope.py)
2026-08-12 kicad/sim: enable-sequence bench (new board) + microscope sections
    Full simulated cascade with firmware verdicts: GPIO14 -> Q1 -> acceptor
    inrush (19.5A/60us through the 220uF input cap; 12V rail sags to 6.0V,
    5V/3V3 ride through untouched) -> ring+indicator currents -> 500ms boot
    suppress -> coins at realistic widths (20ms suppressed in-window; 20/4/
    50ms accepted, 0 fraud). cosim_replay imported for the verdict layer.
    [microscope_scope.py]
2026-08-12 kicad: order-time BOM fixes — D6 DigiKey PN corrected (118-1.5SMC18ACT-ND, verified in stock), J2 Phoenix 1715857 -> generic WJ500V-5.08-3P (KF301 family, JLC-stocked, same 5.08mm 3-pos footprint)
    [EllaFi-PCB.kicad_pcb, EllaFi-PCB.kicad_sch]
2026-08-12 kicad: 0.8mm track width on power net classes (12V, 5V, SW_GND) + classify the lamp return
2026-08-12 kicad: power tracks widened to 0.8mm (user layout pass) + GND stitching vias + D6 PCB field sync
    DRC 0 violations / 0 unconnected; remaining 6 parity notes = known U3
    merged-pad numbering quirk. Gate green.
    [EllaFi-PCB.kicad_pcb]
2026-08-12 gitignore: kicad/fab/ (generated fabrication outputs)
2026-08-12 kicad: LCSC part numbers as schematic fields + one-command JLC export
    Every symbol carries an LCSC field (22 pinned from the verified JLC
    order; J1/J2/J4/J5 pending final connector picks). Mfg_PN updated on the
    6 lines ordered as substitutes: caps -> in-stock Samsung equivalents,
    LEDs -> Lite-On LTST-C150 K-RKT/YKT/KGKT (matcher had offered green for
    the yellow), U1 -> LTV-817S-TA1-B (CTR-binned 130-260%: removes the
    low-CTR tail from the Monte Carlo analysis at the supply level).
    export_jlc.py regenerates gerbers+BOM+CPL from these fields.
    [EllaFi-PCB.kicad_sch]
2026-08-13 kicad: J2 pinned to KF301-5.0-3P / C474882 (in-stock 5.08mm 3P screw terminal)
    [EllaFi-PCB.kicad_sch]
2026-08-14 kicad: pin J1/J4/J5 sockets (Sullins PPPC0/221LFBN-RC) — BOM now fully specified
    All 26 parts carry LCSC numbers; export_jlc.py reports 'fully pinned'.
    Sockets go via JLC Global Sourcing (7-15 days); U1 opto and everything
    else in-stock. Next order needs no re-matching.
    [EllaFi-PCB.kicad_sch]
2026-08-15 omada: de-chunk large client lists straight into PSRAM
    HTTPClient::getString() built the 60-82 KB chunked client-list bodies in a
    contiguous internal-DRAM String; under load (largest block seen 15.8 KB) the
    String silently truncated and deserializeJson failed with InvalidInput on
    perfectly good responses. PsramSink rides the same writeToStream de-chunk
    path but grows in PSRAM, so the big bodies never touch internal DRAM (which
    also frees it for mbedTLS handshakes). Also: grid/devices now pages
    explicitly (currentPage/currentPageSize).
    Zero parse errors in production since deploy (was ~8/day at peak).
    [omada.cpp]
2026-08-15 firmware b64-75: socket discipline, resource forensics, mDNS IPv6, forever admin cookie
    Socket starvation fix (b66/67): close-after-response middleware for non-WS
    requests + per-socket TCP keepalive (chained open_fn) — lingering keep-alive
    from ~67 portal phones had pinned the 12-socket pool and starved outbound
    (the OUT OF SERVICE incident). /admin/sockets panel + dashboard table show
    who holds the pool.
    Resource forensics (b70/74): logResources() two-line WARN snapshots (heap/
    largest/minHeap/psram/allocFails + sockets/queues/tls/fs/nvs) at boot, at
    OUT OF SERVICE, and proactively when tight; heap_caps alloc-failure hook;
    per-task stack head-room every 10 min (WARN only when <1536 B or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
    [files.cpp, globals.h, main.cpp, web.cpp]
2026-08-15 omada-html: captive-portal POC test site (option B de-risking)
    Diagnostic page in Omada's Import Customized Page bundle format. Auto-runs
    a 7-test battery against the ESP from inside the captive browser (image
    beacon, opaque/readable fetch, WebSocket, https probe, poll latency) with
    on-screen timestamped logging, plus manual WS full-protocol and voucher
    auth tests. POC results (iPhone CNA, 2026-08-14): ESP reachable ~20-70 ms,
    WS opens and exchanges messages, controller serves the portal plain HTTP
    :8088 — no mixed content. Remaining gap: session seeding (no_session).
2026-08-15 web b76: /status optionally seeds the session from Omada redirect params + CORS
    The controller-hosted portal (option B) loads the page from the OC220, so
    GET / never fires and the session cache never learns the client. /status now
    accepts the same clientMac/apMac/ssidName/radioId params GET / takes, seeding
    via the same (now shared) seedPortalSession() path incl. paused-session
    restore — so the WS protocol needs no changes: by INSERT COINS time the
    session exists by IP. Access-Control-Allow-Origin: * makes the response
    readable cross-origin (public, unauthenticated data). No params = behavior
    unchanged for the ESP-served page.
    POC page: T4 now exercises the real browsing call (/status?cli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
2026-08-15 omada-html: production controller-hosted portal page + bundle build
    index.html is now the real portal adapted for Omada hosting (diagnostics
    moved to diag.html, still bundled): ESP_HOST baked per site, /status carries
    the redirect params (seeds the ESP session cache, b76+), WS points at the
    ESP, and a voucher form POSTs same-origin /portal/auth — voucher login
    becomes native controller auth that survives an ESP outage (the ESP-served
    page never had a same-origin path to Omada auth). All other behavior —
    coin modal, pause/resume, audio, AP map coloring, reconnect logic — is
    byte-identical to web/index.html.
    make_zip.sh stages assets fresh from web/ and data/ (no duplicates in the
    repo)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
2026-08-15 scripts: upload_portal.py — scripted Import Customized Page
    From the 2026-08-15 HAR capture (cataloged in memory/api_captures/
    portal-page-upload.md, HAR itself gitignored — it carries session cookies):
    two-step multipart upload to files/sites/{site}/portal/page (md5 pre-check,
    then bytes -> fileId), then PATCH setting/portals/{portalId} with the UI's
    trimmed field set + importedPortalPage.id (the full fetched object fails
    validation on portalCustomize). Sites via user/sites + currentPageSize —
    the firmware's working call; plain /sites returns empty.
    Verified live: make_zip.sh && upload_portal.py --portal 'EllaFi Test Portal'.
2026-08-15 omada-html: ESP_HOST injected from config.json static_ip; drop preconnect
    The page's ESP address now comes from the same data/config.json active-env
    static_ip the firmware boots with — one source of truth, injected by
    make_zip.sh at staging time (__ESP_HOST__ placeholder). The preconnect hint
    is removed: as a cross-origin hint it made every captive-sheet open grab an
    ESP socket at HTML-parse time for a ~3 ms LAN saving — the burst-socket
    pattern the close-after-response work exists to prevent.
2026-08-16 sales b77/78: ₱5-unit voucher column, Customers column, pesos Leader, bridge path probe
    Vouchers (*) column = voucher revenue ÷ 5 so it reads in the same ₱5 units
    as Vendo coins (footnote in tfoot). Customers = coin sessions (one
    appendSaleLog line per settle, new per-day sessions field) + vouchers
    redeemed. Leader is now the day's top earner in PESOS: best vendo node vs
    the voucher channel — per-SELLER daily attribution isn't honest with
    650-code batch groups (creation-day attribution collapses daily; verified
    against live data), so vouchers compete as 'Sellers' with a name shown only
    when attributed groups back ≥half the revenue. autogenSellerPrice() shared
    by sales + leaderboard.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
2026-08-16 sales b79: redeemed = sold — daily per-seller attribution from usedCount deltas
    The 2:45am rollup already walks live voucher groups while the ledger still
    holds the previous counts: the delta is what each seller's customers
    redeemed that day. Journal one line per rollup (/seller_days.json,
    365d purge); today = live usedCount minus moneyGroupUsed() (ledger as-of
    last rollup). Replaces the creation-day attribution, which collapsed on a
    daily grain with 650-code batch groups. Leader shows the named seller vs
    top vendo node in pesos; pre-journal days fall back to the channel total.
    Verified live: today shows Darna ₱730 of ₱1,220 voucher revenue.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
    [files.cpp, globals.h, money_store.cpp, money_store.h, web.cpp]
2026-08-16 sales b80: This Week table in ₱5 units + Users columns
    Same normalization as the 30-day table: Activity split into 'Vouchers (*)'
    (coins for vendo, revenue ÷ 5 for sellers — one comparable unit) and
    'Users' (per-node coin sessions, new nodeSessions per-day map; vouchers
    redeemed ≈ users for sellers).
2026-08-16 sales b81: weekly table simplified to Minutes; seller-days history backfill
    This Week table: drop the units/users experiment, columns are now
    Name/Type/Minutes/Revenue/Commission/Net/Δ — leaderboard carries minutes
    (used × group duration), vendo minutes = coins × minutes_per_coin (now in
    the sales response).
    Backfill: every voucher code stores startTime (first use = the sale under
    redeemed-as-sold), so scripts/backfill_seller_days.py rebuilds the daily
    per-seller history from voucher_backups/archive.json (incl. deleted groups)
    and POSTs it through /admin/money/import's new optional sellerDays field.
    Firmware skips already-journaled days, so the nightly rollup always wins
    and re-imports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
    [globals.h, web.cpp]
2026-08-17 sales b82: This Week revenue-share donut + weekly seller trend chart
    /admin/sales days now carry the full per-seller pesos map (sellers{}), so
    the frontend renders: (1) a donut of last-7-full-days revenue share across
    Vendo + sellers, with center total and value/% legend; (2) a multi-series
    line chart of weekly revenue per entity across the whole backfilled journal
    — trailing 7-day buckets ending yesterday, direct-labeled line ends, fixed
    per-entity colors (palette validated for the dark surface). Minutes column
    dropped from the This Week table (user: not valuable).
    [globals.h, web.cpp]
2026-08-18 probe b83: third target — the Starlink dish (192.168.100.1:9200)
    Verified reachable from the LAN. all-OK + failed healthcheck now means the
    outage is beyond the dish (satellite/weather/Starlink network) — the
    definitive in-LAN verdict for the 'Starlink is flaky' theory. gw OK +
    dish FAIL isolates the router→dish segment instead.
    [globals.h, main.cpp]
2026-08-18 uptime report: Starlink × ESP × Omada reliability overlay
    scripts/uptime_report.py pulls three sources into one timeline:
    - dish gRPC get_history (grpcurl, 192.168.100.1:9200): eventLog = the
    Starlink app's Events feed (unix ns) + outages[] micro-drops (GPS-epoch
    ns, +315964782), deduped by start second
    - ESP errors.log: healthcheck failures paired with their path-probe
    verdicts, reboots (power-cut vs clean), memory-tight events
    - Omada v2 logs/alerts: AP_ISOLATE / LINK_DOWN etc. with time filters
    Renders tools/uptime_report.html from uptime_template.html: uptime tiles,
    three-lane timeline (green ground = healthy; mark width = duration,
    severity-colored), hover tooltips, full event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
2026-08-18 uptime report: resolve device MACs to names in Omada alerts
    grid/devices provides the name map, so alerts read 'BES AP was isolated'
    instead of a MAC. Also corrects the record: the AP_ISOLATE alerts are the
    no-UPS mesh APs (BES — shut off nights/weekends — and Negra), NOT the
    EAP215 PtP bridges, which appear in zero alerts.
2026-08-18 probe b84: ghost-hunt instrumentation — was the 4s timeout inventing outages?
    Two self-inflicted suspects found in pingHealthcheck: (1) 4s connect/read
    timeouts vs Starlink's retransmit latency tail — the 4006ms failure cluster
    is the cap being hit, meaning we may have been logging latency spikes as
    outages (explains zero correlation with dish telemetry); (2) the ping
    resolves hc-ping.com fresh each time while every probe target is an IP
    literal, so 'probes OK + ping failed' is also the pure-DNS-hiccup signature.
    Changes: primary timeout 4s -> 10s (if blips vanish, they were ghosts);
    probe adds wan1=1.1.1.1:443 wan2=8.8.8.8:53 (IP-literal internet truth),
    a timed DNS resolution of the h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
    [globals.h, main.cpp]
2026-08-18 uptime report: fourth lane — healthchecks.io outside view
    Read-only API key (config: healthchecks_api_key, gitignored) pulls the
    check's flips: exact down/up transitions of the vendo's pings as seen from
    the internet. Down->up pairs become outage windows on an 'Outside view'
    lane + an unreachable-time tile. A down window = ESP dead (power) OR WAN
    dead; the ESP lane's boot markers disambiguate. First data confirmed the
    Aug 18 grid outage to the second (down 01:14:14 local vs user-reported
    1:15am; restored 11:27).
2026-08-19 uptime report: Starlink router health tiles (the actual LAN gateway)
    Topology correction: the ER706W has been dead for months (storm) — the
    Starlink Gen3 router IS the LAN gateway/NAT at 192.168.1.1, straight into
    the House Switch. Its gRPC (192.168.1.1:9000, same Device/Handle shape as
    the dish) now feeds three tiles: router uptime, clients NAT'd (warn >100),
    and the router's own pop-ping drop rate (5m) — the discriminator between
    'upstream drops' and 'router NAT sheds flows under piso-wifi client load'.
2026-08-21 omada device-plane: Week-1 go/no-go = GO (lab extraction)
    Scaffolds the Mac-local feasibility lab (throwaway SW controller 5.15.24.19
    in Docker + Python emulator on a bridge net) and the extraction toolchain.
    tools/omada_recon.py rips + hunts the controller jars; jadx decompile of
    manager-core/omada-common/ecsp-common settles the crypto question.
    VERDICT GO — nothing on the ECSP device plane is unreproducible per-device:
    - netty RSA private key = fixed embedded constant (TEA-obfuscated in
    ecsp-common GlobalConfig), same across controllers, recoverable locally
    - symmetric keys via deterministic SHA1PRNG-seeded KeyGenerator (k(str),
    omada-common) — reproducible in Python/Node AND on E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
2026-08-21 omada device-plane: netty RSA private key recovered + validated (local)
    Ran the controller's own GlobalConfig.NETTY_RSA_PRIVATE_KEY via jshell
    (ecsp-common on classpath) — no TEA reimpl needed. Valid 1024-bit RSA key,
    pubkey fp 1e1a9107…; stored gitignored. 'Recoverable' is now a validated
    artifact. Emulator handshake fully unblocked.
2026-08-21 gitignore: dev/_key.pem (transient key material)
2026-08-21 emulator: SHA1PRNG key-derivation reproduced + verified vs JVM
    dev/emulator/omada_crypto.py reproduces Omada's k(str) AES-key derivation
    (SHA1PRNG-seeded KeyGenerator). Self-test passes against 3 ground-truth
    vectors captured from the real JVM via jshell — exact byte match, first try.
    Second-hardest crypto piece done; emulator can now derive any inform key
    from its seed string.
2026-08-21 omada device-plane: full ECSP wire spec extracted
    The device plane is JSON, not protobuf: 4-byte big-endian length prefix +
    {header,body} UTF-8 JSON. header.type selects the message (DISCOVERY=1,
    PRE_ADOPT=2, ADOPT=16/32, INFORM=256, ...); optional LZO compress. Discovery
    = UDP 29810, manage/adopt = TCP 29811-29814. Full type table + adoption
    sequence in dev/protocol-ecsp.md. Protocol fully reverse-engineered; only
    the per-channel crypto application remains to trace while building the
    discovery beacon.
2026-08-21 omada device-plane: full protocol RE + working discovery emulator
2026-08-21 adopt: verified RSA+RC4+ecsp2_auth crypto; full handshake mapped
    manage_crypto.py: RC4 (vs canonical vector), RSA pub-encrypt/verify via the
    recovered controller key, and ecsp2_auth = SHA256(SHA256(user+md5(pw))+rand).
    adopt_client.py: bidirectional discovery (confirmed controller sends no UDP
    reply; manage channel is device-initiated on 29811). adopt-handshake.md now
    documents the complete flow: DEVICE_VERIFY_INFO(admin/admin auth) needs a live
    ADOPTING_PRE_CONNECT context -> DEVICE_VERIFY_RESPONSE -> PRE_CONNECT ->
    AdoptRequest(account+deviceKey). Only the manage-channel framing key is left
    to resolve empirically.
2026-08-21 adopt: manage-channel framing resolved (v1 plaintext, v2 RC4), all crypto known
    Live probing: DEVICE_VERIFY_INFO reaches the manage channel and its plaintext
    framing parses on v1 (29811, 'do not handle' — wrong version server). It's a
    V2 type → belongs on 29814, which is RC4-framed with the fixed getEncryptKey()
    (silently closes plaintext). Recovered the last unknown: that fixed key =
    TEAUtils.decrypt(ENCRYPTED_ENCRYPT_KEY), TEA KEY/DELTA/64-rounds documented.
    Every crypto primitive across the whole protocol is now solved; adopt-handshake.md
    lists the exact remaining integration (tea_decrypt → RC4 v2 frames → verify →
    adopt → inform → config push).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
2026-08-21 reference: per-device-type field table (AP/gateway/switch) + temperature answer
    Fields are per device-type AND per stage. Discovery (pre-adopt) = short list;
    inform (post-adopt) = full vitals. Temperature is an INFORM field on all types
    (AP temp, gateway temp+OsgDeviceTemperature threshold, switch devTemp) — so the
    ER706W shows it as a gateway, and our spoof can too (ESP32-S3 die temp) once
    adopted. Table maps every field to its ESP source + flags gateway-only fields
    (fan, rps) and the type-spoof tradeoff.
2026-08-21 reference: health spider-graph → EllaFi resource monitor (socket% as channel usage)
    The health graph dimensions come from AP WirelessInfo inform (busyUti/interUti/
    txUti/rxUti + cpuUti/memUti); controller derives the 0-10 score with history.
    Map socket-pool % onto busyUti (channel usage) so socket exhaustion shows as
    channel-usage=100%/health-red with a timeline — the OUT-OF-SERVICE resource
    made visible in Omada. Full dimension→EllaFi mapping table added.
2026-08-21 adopt: fixed RC4 key recovered + v2 RC4 framing built (verify not yet landing)
    Recovered RC4Utils.getEncryptKey() (256-char embedded key) via the controller's
    own TEAUtils.decrypt. Added rc4_frame/rc4_unframe (RC4'd 4-byte total-length +
    RC4'd payload, matching TcpEncryptInternalDecoder: length field = 4+payload).
    Client sends RC4-framed DEVICE_VERIFY_INFO to v2 port 29814.
    STATUS: verify not landing yet. The v2 channel closes with no parse log, and the
    device keeps timing out of Pending. Likely a negotiation-first step (DEVICE/
    SYSTEM_NEGOTIATION establishes a session key before verify) and/or precise
    ADOPTING_PRE_CONNECT timing not yet coordinated. All crypto solved; the v2
    handshake stat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
2026-08-21 adopt: BREAKTHROUGH — v2 manage channel (29814) is TLS-wrapped, not raw-RC4
    Handshake probe proves 29814 completes TLS (TLS_AES_256_GCM_SHA384, server cert,
    no client-auth); 29811/29812 refuse TLS. The earlier 'silent close on plaintext'
    was the TLS handshake failing on raw bytes — nothing reached the ecsp decoder,
    hence zero parse log. Inside the TLS tunnel, frames are plaintext length-prefixed
    JSON; RC4 is only a post-adopt pipeline upgrade (reinitRc4Handler) keyed by the
    per-device session key from adopt, NOT the fixed getEncryptKey (that was a wrong
    turn). Verified by DEBUG-instrumenting the controller (log4j2 ecsp=debug + netty
    byte logger): a plaintext DEVICE_VERIFY_INFO inside TLS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
2026-08-21 adopt: document downstream shapes (PRE_ADOPT/ADOPT_REQUEST) from server/e/b.java
    AdoptRequest body = {data:base64(payload), hash:base64(SHA(payload)),
    sig:SHA1withRSA(payload)}; device verifies sig+hash then RC4-decrypts payload
    with the session key -> account+deviceKey. Session-key ordering (RSA-wrapped key
    handed up during pre-connect, before the controller RC4-encrypts the account)
    must be verified against a real capture, not guessed. Downstream client stages
    deferred by design until we capture a real AdoptRequest on Adopt-tap.
2026-08-21 adopt: username auto-syncs via needUsername; RSA decrypt-pub for the account push
    Empirically mapped the full V2 adopt flow with DEBUG instrumentation + user taps:
    - 29814 pre-connect: sending PRE_CONNECT_INFO{needUsername:true} makes the
    controller return the typed username in PreConnectInfoResponse.username -> the
    username auto-syncs through the protocol (confirmed: got username='admin').
    - The password is delivered separately: on Adopt tap the controller sends a
    PRE_ADOPT_REQUEST via UDP ({mac, ip, adoptPort}); the device must connect the
    ADOPT channel at ip:adoptPort, where the controller pushes ADOPT_REQUEST =
    {data,hash,sig}, data = base64(RSA_priv(username + 0x00 + MD5(passw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
2026-08-21 adopt: MUTUAL AUTH COMPLETE — emulated device passes Omada V2 adoption
    End-to-end, empirically verified against the lab controller:
    - discovery -> Pending, PRE_ADOPT_REQUEST received via UDP (adoptPort=29814); the
    fire-and-forget beacon was the blocker — listening on the same socket + advertising
    ip=192.168.65.1 (host as the container sees it) lets the reply through Docker NAT.
    - adopt channel (TLS 29814): PRE_CONNECT_INFO{needUsername} -> controller returns the
    typed username in PreConnectInfoResponse.username (username auto-syncs via protocol).
    - DEVICE_VERIFY_INFO(ecsp2_auth(user, factory-pass, rkdv)) -> DEVICE_VERIFY_RESPONSE
    error:0. Controller log: 'deviceAuthPair match dev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
2026-08-21 adopt: document confirmed end-to-end V2 auth flow + remaining config phase
2026-08-21 adopt: DEVICE_NEGOTIATION accepted (RC4 session key handed over); config push is the last blocker
    After VERIFY_RESULT_ACK the driver sends DEVICE_NEGOTIATION (body=BaseAdoptResponse:
    key=base64(RSA_pub(rc4SessionKey)), deviceInfo.encryptedHwId/OemId=base64(RC4(v,key))).
    Controller accepts it ('handle negotiation Message type device.negotiation'), sets the
    server route cache, and logs 'send event with real adopt info' — it's ready to hand over
    the real site account. No manager-side decrypt error.
    BUT the controller then never pushes INIT_SYNC/SET_REQUEST -> 'timeout wait adopt watch
    result'. So the post-negotiation config-push trigger is still unknown: the device likely
    must proactively dr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
2026-08-21 adopt: CONFIG CHANNEL SOLVED — device fully adopted, config RC4-decrypted
    DEVICE_NEGOTIATION(1048580, ApAdoptRespV2Body) hands the controller our RSA-wrapped
    RC4 session key -> reinitRc4Handler flips the channel to RC4 both ways. Required body
    fields nailed empirically via the config-builder's NPEs/parse errors: devCap with
    logNotification (else deviceimage.ap NPE), configVersion, notSupportComponents={} (Map
    not array), and components_v2 declaring wlanBasic/ssidInform/... (else 'send empty
    setting'). Controller then RC4-pushes SYSTEM_NEGOTIATION(1048581) = V2 initial config
    sync; device acks INIT_SYNC_RESULT(1048582) -> 'receive adopt success event' (ADOPTED).
    The SYSTEM_NEGOTIATION body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
2026-08-21 adopt: END-TO-END COMPLETE — device reaches CONNECTED + receives SET_REQUEST provisioning
    The last blocker was framing asymmetry: the controller RC4s OUTBOUND (we decode
    SYSTEM_NEGOTIATION with our session key) but its INBOUND decoder for our frames stays
    PLAINTEXT (reinit only flips outbound in practice). Sending post-negotiation acks as
    plaintext -> controller logs 'handle negotiation init.sync.result' -> 'update device
    status to CONNECTED' -> INIT_SYNC_RESULT_ACK -> INFORM_RESPONSE -> SET_REQUEST(4096).
    Full chain now works: discovery -> PRE_ADOPT(udp) -> TLS adopt -> verify(admin/admin
    factory) -> DEVICE_NEGOTIATION(RC4 key) -> SYSTEM_NEGOTIATION(config+account, RC4-decrypted)
    -> INIT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
2026-08-21 adopt: persistent connection — INFORM heartbeat keeps the emulated device online
    After reaching CONNECTED + capturing the SET_REQUEST, the driver no longer exits: it holds
    the manage channel open and sends a periodic INFORM_REQUEST heartbeat. Controller answers
    INFORM_RESPONSE each cycle and never removes the device context — the emulated EAP225 stays
    green/online in the Omada app indefinitely. Also fixed a var-clobber (loop reused the UDP
    socket name 's') and removed the break-on-capture so the session persists.
    Full Phase A proven end to end and STABLE: an emulated ESP32 is discovered, adopted,
    authenticated, provisioned (SSID+passkey via SET_REQUEST), and stays Connected.
    Co-Authore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
2026-08-21 adopt: auto-reconnect + full vitals INFORM (health graph, IP, temp)
    Two fixes driven by realism gaps the user spotted:
    1. INFORM heartbeat now carries a full vitals body (inform_body): per-radio WirelessInfo
    (wSettings_2G/5G with busyUti=channel-usage, interUti, txUti/rxUti), deviceInfo
    cpuUti/memUti/ip/temp/nf. This drives the device Health spider graph, shows the IP,
    and reports temperature. (For EllaFi: busyUti←socket-pool%, memUti←heap, temp←die temp.)
    2. Auto-reconnect: main() no longer has a 300s cap and no longer requires a manual
    re-adopt to reconnect. On startup / after any channel drop it PROACTIVELY opens the
    manage channel (drive_adopt_channel(29814)) — an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
2026-08-21 adopt: fix the ~60s drop — fast heartbeat keeps the connected route alive
    Root cause: the ecsp connected server route expires (~60s) and is refreshed by the
    INFORM keepalive (server/a/b/d.java -> context/c.java a(mac,channel,type)) only when
    status==CONNECTED AND channel==A(), and only re-arms the route once
    updateServerRoutePeriod elapses. A slow 10s heartbeat let the route TTL lapse in the
    gap -> controller closed the channel every ~60s. Real devices inform ~1s (informInterval
    deviceInfo=1). Fix: drop to a 3s heartbeat once CONNECTED -> route stays refreshed ->
    device holds connected indefinitely (verified past 5 min, steady seq 99..104).
    Auto-reconnect after a genuine drop still settle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
2026-08-21 adopt: SET_RESPONSE confirms configVersion -> device shows Connected (not Configuring)
    The device was stuck at DeviceStatusEnum CONFIGURING (status 11) because SET_RESPONSE
    only sent error=0. BaseConfigResponse carries {sequenceId, configVersion}; the controller
    waits for the device to confirm it applied the pushed configVersion before marking it
    CONNECTED. Fix: echo the SET_REQUEST's sequenceId + configVersion back in SET_RESPONSE, and
    report the applied configVersion in subsequent DEVICE_NEGOTIATION. Result: controller now
    broadcasts status 14 = 'Connected' (statusCategory 1), steady.
    Full lifecycle now correct: adopt -> provision -> apply/confirm config -> Connected, with
    the fast-heartb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
2026-08-21 adopt: fix the flapping — remove the INFORM/INIT_SYNC_RESULT race + live vitals
    The Heartbeat-Missed/Configuring flapping was a race: after INIT_SYNC_RESULT (which sets
    status CONNECTED asynchronously) the driver sent the first INFORM immediately; the
    controller processed the INFORM on another thread before the status transition, so the
    keepalive (context/c.java) saw status ADOPT_SUCCESS != CONNECTED and closed the channel ->
    proactive re-link -> full re-adopt -> brief Configuring/Heartbeat-Missed -> repeat.
    Fix: don't INFORM immediately after INIT_SYNC_RESULT — let the 3s heartbeat send the first
    INFORM once CONNECTED has settled. Also made the INFORM vitals LIVE (upTime climbs, cpu/me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
2026-08-21 adopt: report ssidStats (configured SSIDs broadcasting) -> device settles to Connected
    The manager kept the device in Configuring/Provisioning because it wasn't seeing the pushed
    SSIDs on the air. Now the driver captures the SSIDs from the SET_REQUEST (id+name per band)
    and reports them live in the INFORM as ssidStats_2G/5G (with a MAC-derived BSSID). Combined
    with the live progressing vitals + the INFORM/INIT_SYNC race fix, the device now settles to
    status 14 (Connected, netStatus=CONNECTED) and holds steady; the transient Provisioning/
    Heartbeat-Missed flashes are only the per-restart reconnect settling.
2026-08-21 docs: Omada emulator Phase-A README — full protocol, crypto, files, findings, remaining work
    Clean top-level write-up tying together the whole build: what works end to end (discovery ->
    TLS adopt -> auth -> RC4 config -> SSID capture -> stable connected + vitals + auto-reconnect),
    the recovered crypto, the file map, the v2 message-type table, the connected-lifecycle findings
    (route keepalive, INFORM race, informIdle, configVersion+ssidStats), device status codes, and
    the well-scoped remaining polish (per-feature config-apply confirmation + site-state validation).
2026-08-21 docs: master ECSP protocol reference — full message-type table, header, bodies, config schema
    Complete MessageType enum (37 types w/ values, body classes, direction), MessageHeader
    structure, transport/framing (TLS 29814, RC4 re-key direction asymmetry), the full config
    surface (SYSTEM_NEGOTIATION + SET_REQUEST feature sections mapping to the app's config-result
    rows), status codes, and the key reconnect clue (PreConnectInfo.rebuild + token). Foundational
    reference for the emulator + eventual ESP32 firmware; behavioral per-protocol detail being
    appended from a parallel deep code trace.
2026-08-21 docs+fix: full device-plane protocol reference (deep code trace) + SET_RESPONSE errcode
    Reverse-engineered the ENTIRE Omada device protocol from the decompiled controller (7 parallel
    code-trace agents), documented in omada-protocol-reference.md:
    - Config-apply: batched SETs, sequenceId correlation, errcode/configVersion, 2600 timeout,
    CONFIGURING->CONNECTED when all sequenceIds acked.
    - Provisioning state machine: when config is (re)pushed (version bump / adopt / rebuild, NOT
    every reconnect), configuring timeout revert.
    - INFORM contract: only deviceInfo load-bearing, changing seq (dedup), everything else optional.
    - Reconnect/REBUILD/RC4-rekey: clean re-link path (no re-provision) via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
2026-08-21 docs: root-cause the pending-site reset + heartbeat timeout; grounded reconnect plan
    'Invalid v2 adopt process with pending site' (g.java:76) = the device parked in the placeholder
    site 'PENDING-SITE' gets its v2 pre-connect rejected on a standalone controller -> channel closed
    -> Pending. Caused by full-readopt churn leaving the device site-less. HB-missed timeout = 60s
    busy/180s idle (20s poll); steady 3s heartbeat never trips it — the flashes were reconnect gaps.
    Added the grounded stable-reconnect implementation plan: lightweight RE-LINK via REBUILD_REQUEST
    (no re-provision) instead of full re-adopt; PreConnectInfo.rebuild/token as the reconnect signal;
    fresh MAC to clear a PENDING-SI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
2026-08-25 dev/emulator: 6.2 device-plane emulator — full adoption, vitals, clients, alerts, firmware indicator
    - Adoption works end-to-end on controller 6.2.14.11: 36-char randomKeyForSystemVerify,
    learned Device Account reconnect, RSA-wrapped session key (secrets from gitignored .local).
    - Genuine EAP225-Outdoor identity: plain hwId/oemId negotiation keys + real 5.x firmware
    version, so the controller's cloud firmware check runs and the upgrade indicator is
    device-drivable via the reported version (GitHub-check → version sentinel → indicator).
    - Live reporting: synthetic client population + per-radio traffic; critical-error alerts
    injected into Device→Logs (EapSysLog); env-gated mesh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
2026-08-25 rename dev/ -> omada-lab/ (Omada interop lab); add omada_requirements.md
    - dev/ was a generic name for what is specifically the Omada device-plane research
    + emulation lab: throwaway Docker controller, Python device emulator, mechanism
    docs, and gitignored decompiled-controller analysis. Renamed for clarity.
    - compose project name is pinned (ellafi-omada-lab), so the controller's named data
    volumes are unaffected by the directory rename.
    - fixed internal dev/ path references in the moved docs/scripts (left /dev/* alone).
    - .gitignore paths updated dev/ -> omada-lab/.
    - add omada-lab/omada_requirements.md: original Omada-integration requirements + live status.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
2026-08-31 sim: re-validate for EL357N opto (replaces LTV-817S package mismatch)
    Full suite re-run ALL PASS with the EL357N model. Datasheet-confirmed
    identical pinout + 6V LED reverse rating (coin-fault margin unchanged).
    Measured a real CTR/noise tradeoff: higher CTR passes coupled solenoid
    noise to GPIO4 at the hardware level (>CTR 1.0). Firmware width filter is
    the CTR-independent defense (cosim: 0 false coins at all CTR). Chose the
    (B) 100-200% bin (C6649) over (C) 200-400% for defense-in-depth noise
    margin while keeping coin-detection headroom to end-of-life. g4_min_noise
    reframed as informational; cosim_replay is the authoritative noise check.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
2026-09-02 opto finalized: TLP185(GR-TPL,SE) / C128776 (EL357N out of stock)
    As-ordered part after the EL357N sold out in every bin. Toshiba TLP185,
    GR CTR bin 100-300%, SOP-4-2.54mm (JLC confirmed footprint match),
    identical pinout. Sim re-run for the GR CTR range: ALL PASS (coin lows
    0.054V at CTR 3.0/1.0/0.6, Monte Carlo 60/60).
    Honest finding: TLP185 LED reverse rating VR=5V (vs 6V for 817/EL357N).
    The 12V-short-onto-coin-wire fault drives the LED to 5.5V reverse, 0.5V
    over — fault-only, transient, F1 trips, low risk on this batch. Logged
    as a rev-B item (coin-line reverse clamp) in TODO.md + README; opto_vrev
    bench now INFO. Schematic U1 + fab BOM updated to C128776.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
    [EllaFi-PCB.kicad_sch]
2026-09-04 omada-lab: codify the full bidirectional field catalog
    Every field exchanged device<->controller across all 22 message types:
    handshake bodies, the INFORM heartbeat (deviceInfo/wSettings/clients/
    ssidStats/radioTraffic/log/mesh), controller config + credential push,
    and the parser traps that silently abort informs. Consolidates the
    protocol reference, device-field-table, field-map, and log-alerts design
    into one data-model doc + an ESP32 port checklist.
2026-09-05 todo: SSL -32512 OUT-OF-SERVICE is fixed (f39cfc7) — move to Done
    The open 🔴 entry was stale; the PsramSink de-chunk-into-PSRAM fix
    (committed f39cfc7) is the complete root fix. Recorded the mechanism +
    the live re-confirm signal.
2026-09-06 admin: activity log + resource-history monitor (build 84)
    New /admin/activity (AUTH/EXTEND/REFUND coin events via appendActivityLog)
    and /admin/resources (sampleResources pushes heap/uptime/socket snapshots
    into a history ring, sampled from loop()) + admin UI. Also demotes the
    per-request Omada HTTP + coin-pulse chatter from INFO to DEBUG. Build ->84.
2026-09-06 omada_device: Phase B M1 foundation — crypto layer (verified on hardware)
    New src/omada_device.{h,cpp}: RC4, MD5/SHA256-upper, ecsp2_auth, and RSA
    public-key PKCS1v15 wrap (mbedtls) — the primitives the ECSP adopt
    handshake needs, ported faithfully from omada-lab/emulator (the
    controller compares digests byte-for-byte). Self-test asserts the
    emulator ground truth: RC4 canonical vector, MD5(""), SHA256(abc), and
    ecsp2_auth('admin','admin',rk)==D1D728F6… — confirmed ALL PASS on the
    ESP32-S3 (errors.log, build 85). Wired dormant in setup(); no handshake
    yet. Transport/discovery/adopt are the next increments (M1 continues).
    [globals.h, main.cpp, omada_device.cpp, omada_device.h]
2026-09-06 omada_device: discovery beacon (UDP :29810) + omada_device_enable flag
    Ports discovery_beacon.py: plaintext [len][JSON] frame, type=1, md5("default")
    controllerId -> PENDING. omadaDeviceTask beacons L3-directed to the
    controller host + subnet broadcast every 30s; real MAC/IP/vitals. Gated by
    config omada_device_enable (default false). Build ->86.
    NOTE: discovery is LAN-only — only reaches a LOCAL controller (lab/Daram),
    not a cloud controller. Not yet the adopt handshake (next increment).
